conorpp/u2f-zero/hardware/case/u2f-zero-case v16.iges

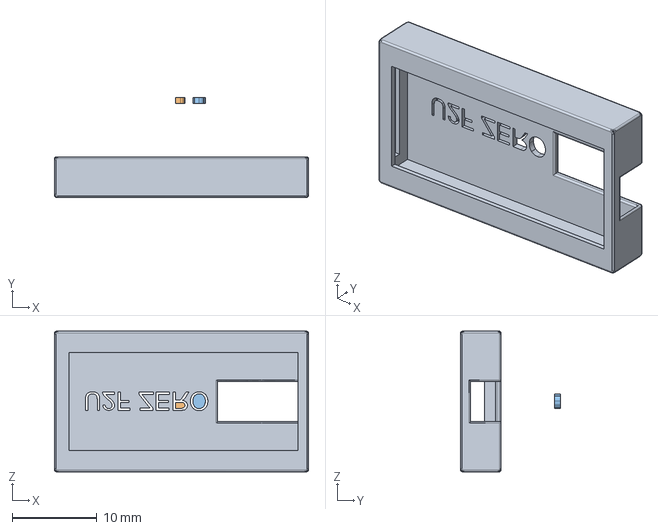
[picture p1: CAD file, 2016-05-28]
hardware/case/u2f-zero-case v16.iges
30.0 x 11.8 x 16.6 mm
