conorpp/u2f-zero/mechanical/flashing_harness.FCStd

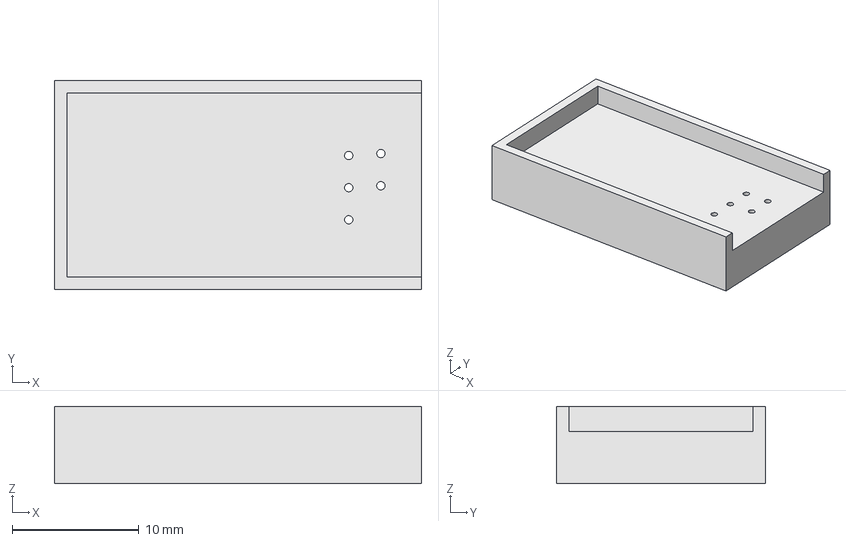
[picture p2: CAD file, 2016-06-05]
mechanical/flashing_harness.FCStd
29.0 x 16.5 x 6.10 mm
