conorpp/u2f-zero/hardware/case/u2f-zero-case .stl

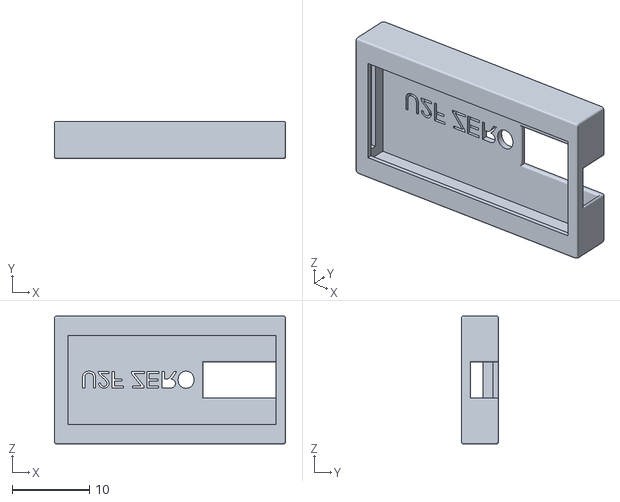
[picture p3: CAD file, 2016-05-28]
hardware/case/u2f-zero-case .stl
30.0 x 4.80 x 16.6
