conorpp/u2f-zero/(list of files, cad)

Other CAD files:
mechanical/flashing_harness.stl
