conorpp/u2f-zero/(threads)

Thread 17 (2016-06-23):

Consider crowdfunding

mkroman, 2016-06-23:
Hi - I love the project, thanks for making it! Already looking forward to building one soon.

Have you considered starting a crowdfunding campaign to get a low-cost u2f solution into the hands of the people?

I was thinking something like submitting it to http://www.seeedstudio.com/propagate/app/start/ and getting a quotation, then maybe create a project on https://www.crowdsupply.com/ to gather the funds and manufacture in larger bulk at a much lower cost.

With that said, I have no experience with manufacturing or crowdfunding - I just think it's something people would be interested in.

conorpp, 2016-06-23:
I'm currently in the process of ordering a small batch to be assembled after which I'll probably put on Amazon.

Crowd funding seems cool; I'm just not all convinced it would be necessary for this project.  If the order I'm currently in the process of eventually sells out then it will be worth it to look more into this.

I can create a timeline for this in the wiki if other people want to be involved.

jpouellet, 2016-06-24:
[int3.cc](http://int3.cc/) ([about](http://int3.cc/pages/about-us)) is relevant too, but I think you're on the right track already.

Closed 2016-08-15.

Thread 21 (2016-07-05):

1.6 mm PCBs are too thin

conorpp, 2016-07-05:
2-2.4 mm PCBs will make a proper connection.  1.6 mm like from Osh park will be wobbly and require some electrical tape or something similar to be added.

Currently updating wiki to reflect this and recommend a different PCB fab.

conorpp, 2016-07-08:
updated wiki with other options

Closed 2016-07-08.

Thread 23 (2016-07-12):

Add a way to make it updateable via USB

jumoog, 2016-07-12:
add FTDI FT2232 to make the u2f-zero updateable via USB (using the C2/JTAG interface of the EFM8UB1 series)

conorpp, 2016-07-12:
I'm not sure what you mean "using the C2/JTAG interface of the EFM8UB1 series".  It's can always be updated via the C2 interface.

To update over USB, there needs to be a bootloader.  There is probably a 1-2 KB of program memory leftover that the bootloader could be written in.  However, I don't think it would be any more convenient of a DIY project as the initial bootloader must be programmed via the C2 interface anyways.

jumoog, 2016-07-12:
i dont want spend money on a extra programmer

conorpp, 2016-07-13:
Assuming that everyone has an Arduino lying around, you could get this project to work:

https://github.com/x893/C2.Flash

Happy hacking!

jpouellet, 2016-07-15:
From a security perspective I do not like the idea of it being re-programmable over USB. The more complex of an interface you expose from the device to the machine you plug it into, the larger your effective attack surface.

The code required for the USB stack is non-trivial, and I would even be in favor of punting that to a separate USB->serial FTDI chip (or Cortex-M0 or something, because of FTDI's "anti-piracy" shenanigans), but the trade off there is increased cost per device.

Closed 2016-07-12.

Thread 24 (2016-07-25):

settings for making project in Simplicity Studio

bensteinberg, 2016-07-25:
I'm having trouble building the project in Simplicity Studio. I got past some errors by installing the Keil license, but I'm still seeing some problems: one is `*** ERROR C249 IN LINE 368 OF /Users/ben/Documents/code/u2f-zero/firmware/src/u2f_atecc.c: 'DATA': SEGMENT TOO LARGE` -- when I change the memory model (in project properties, C/C++ build settings) from small or compact to large, I get `*** ERROR C202 IN LINE 57 OF /Users/ben/Documents/code/u2f-zero/firmware/lib/efm8ub1/bsp/efm8_memory_lcd/src/spi.c: 'BSP_DISP_CS': undefined identifier`. Can you tell me what your settings are for building this project?

conorpp, 2016-07-26:
You should not need to change the memory model.

I'm a little confused for your second error because `u2f-zero/firmware/lib/efm8ub1/bsp` does not exist in the repo and should not be there.  Compiling more code then necessary would cause an issue.

Double check that the optimization level is 9 and that optimization favors size (properties -> settings -> C/C++ build -> optimization).  Also the device should be shown as EFM8UB10F16G in project explorer.

tbh I would start over and reimport the project now that you have the Keil license worked out.

bensteinberg, 2016-07-26:
Thanks! I deleted, re-cloned, and imported the project -- now I'm getting the following five errors:

    *** ERROR L127: UNRESOLVED EXTERNAL SYMBOL
    SYMBOL:  __attest
    MODULE:  ./src/u2f_atecc.OBJ (U2F_ATECC)

    *** ERROR L127: UNRESOLVED EXTERNAL SYMBOL
    SYMBOL:  __attest_size
    MODULE:  ./src/u2f_atecc.OBJ (U2F_ATECC)

    *** ERROR L128: REFERENCE MADE TO UNRESOLVED EXTERNAL
    SYMBOL:  __attest
    MODULE:  ./src/u2f_atecc.OBJ (U2F_ATECC)
    ADDRESS: 1003C86H

    *** ERROR L128: REFERENCE MADE TO UNRESOLVED EXTERNAL
    SYMBOL:  __attest
    MODULE:  ./src/u2f_atecc.OBJ (U2F_ATECC)
    ADDRESS: 1003C88H

    *** ERROR L128: REFERENCE MADE TO UNRESOLVED EXTERNAL
    SYMBOL:  __attest_size
    MODULE:  ./src/u2f_atecc.OBJ (U2F_ATECC)
    ADDRESS: 1003C50H

I have the device and the debug adapter connected, but I presume it's not necessary for the build step.

conorpp, 2016-07-26:
You need to program the setup build file first and then run configuration
script to generate the attestation certificate (__attest symbol).

See the steps in the wiki. Building a U2F token -> Programming.

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

bensteinberg, 2016-07-26:
Ah, of course. I did that, but didn't copy the certificate over from the first attempt. I'll try it this evening when I get back to that computer.

bensteinberg, 2016-07-27:
OK, I got it to compile -- I think I may have messed up the attestation certificate, though. I'll close this ticket, solder up another one, and start from scratch. Thanks for your help!

conorpp, 2016-07-27:
You can just reprogram the setup.hex file rerun the configuration to make
another attestation certificate and it will still work.

bensteinberg, 2016-07-29:
Thanks, working fine now -- it might even have been working fine earlier, except that the device never pulsed a green light, only red. I've checked the device at https://demo.yubico.com/u2f, though, so I know it works. I may have soldered the LED in backwards.... BTW, the photo at the top of https://github.com/conorpp/u2f-zero/wiki/Building-a-U2F-Token is of an old revision of the board, looks like. I'd offer up a picture of mine as a current example if I were more convinced of its correctness.

conorpp, 2016-07-29:
Nice.  Yes the pcb photo is on an out of date pcb but all the part
orientations are the same.  If the red dot on the LED is oriented on the
left side then it is correct.  Another soldering issue could be that the
red and green pins got bridged.

If you can get a good image of your board (which is the latest pcb) that
would be great to replace the old image on the wiki.

On Jul 29, 2016 8:57 AM, "Ben Steinberg" <notifications@github.com> wrote:

Thanks, working fine now -- it might even have been working fine earlier,
except that the device never pulsed a green light, only red. I've checked
the device at https://demo.yubico.com/u2f, though, so I know it works. I
may have soldered the LED in backwards.... BTW, the photo at the top of
https://github.com/conorpp/u2f-zero/wiki/Building-a-U2F-Token is of an old
revision of the board, looks like. I'd offer up a picture of mine as a
current example if I were more convinced of its correctness.

—
You are receiving this because you commented.

Reply to this email directly, view it on GitHub
<https://github.com/conorpp/u2f-zero/issues/24#issuecomment-236173315>, or mute
the thread
<https://github.com/notifications/unsubscribe-auth/ADwm9S7-pNs1qB8F4212_JnqdScfesu8ks5qafjEgaJpZM4JUEaU>
.

bensteinberg, 2016-08-03:
Thanks. I had the LED rotated 90 degrees. Rework on a hot surface did the trick. I've been trying to get a good photo, but haven't managed one yet with decent lighting, nice soldering, clean component placement, and visible component markings. I'll try some more, and have more PCBs coming from Dirty PCBS if I can't get a good shot of one of my first three devices.

Closed 2016-07-27.

Thread 25 (2016-09-08):

[Hardware] Key Ring Durability

erichahn, 2016-09-08:
I've been having some issues with how much the keyring hole has been worn away.
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
*I think we have the same key ring

I also lost C4 a while back. I blame heating the pad too long, my fault on that one.

martenwikman, 2016-09-10:
I think it would be a good idea if the board was extended a little so the hole would have more clearance to the board edge. Hole should be plated and some VIAs inserted in the pad itself like the picture below ( picture stolen from https://blogs.mentor.com/tom-hausherr/blog/tag/pcb-mounting-holes/)
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

jaredfolkins, 2016-09-25:
Instead of modifying any design I used an aftermarket keychain solution for low friction. The wire is wrapped in plastic.

https://www.amazon.com/bayite-BYT-WKC-4INP12-Inches-Stainless-Keychains/dp/B01CLGTBFA

Works fine and the wear is not severe nor do I anticipate the device to fail or become lost because of the wear in the keyring hole.

YMMV

alleybeachelectric, 2016-12-21:
Is there a 3d printable case that could be used to protect the PCB? If not, I don't mind creating one ;)

conorpp, 2016-12-25:
Yes, although it might not be very good.  Improvements/replacements welcome :)
https://github.com/conorpp/u2f-zero/tree/master/hardware/case

rspeed, 2017-01-16:
I wonder if something like Plasti Dip would be a good solution for this.

conorpp, 2017-01-25:
Updated PCB to use a plated hole / via as suggested by @martenwikman

Closed 2017-01-25.

Thread 28 (2016-09-29):

[Question] Porting u2f-zero to Digispark

Akasurde, 2016-09-29:
This is rather a question than a issue.
Can we port this port this code to [DigiSpark](http://digistump.com/category/1) ? It would be nice.

ccoenen, 2016-09-29:
This circuit uses a [cryptographic coprocessor](http://www.atmel.com/Images/Atmel-8923S-CryptoAuth-ATECC508A-Datasheet-Summary.pdf) which is not on the digispark. At the very least this would have to be added. I'm not sure the ATtiny on the Digispark could even talk to it. It does not have I2C, so you'd have to [jump through some hoops](http://playground.arduino.cc/Code/USIi2c) to get this set up first.

I'm not directly involved in this project, so a more detailed answer would have to come from the actual author.

conorpp, 2016-09-29:
The code was written so it could be ported easily.

It does use an I2C peripheral to handle ECC and SHA256 operations.  So you would have to fill in the API calls like [u2f_ecdsa_sign](https://github.com/conorpp/u2f-zero/blob/master/firmware/inc/u2f.h#L162), [u2f_new_keypair](https://github.com/conorpp/u2f-zero/blob/master/firmware/inc/u2f.h#L170), [u2f_sha256_start](https://github.com/conorpp/u2f-zero/blob/master/firmware/inc/u2f.h#L170), etc. with your own implementation.

The final U2F Zero firmware is about 15 KB which is already more than the 8 KB of the ATtiny.  Adding software implementations of ECC operations and SHA256 would be impossible.  Even if you could, it would be very slow -- on the scale of 1-10 seconds per ECC operation.

Akasurde, 2016-10-03:
@ccoenen @conorpp Thanks for info.

Closed 2016-09-29.

Thread 29 (2016-09-30):

Add method for unregistering individual services

zachreizner, 2016-09-30:
If I run out of space, I have to reregister every server just to make room. Not a problem right now, but I have 2 or 3 registrations I made just to test out the device.
Also consider making the 15 slot limit more prominent. That fact, along with the wipe-only removal option, came as an unhappy surprise to me while digging through the wiki.
Cool project though. I might buy another one just for testing.

conorpp, 2016-09-30:
Good point to bring up.

U2F prohibits having any identifiers for privacy reasons so that makes it tricky to delete individual services.  One idea I had was to have an option to delete the last service you authenticated to.

I decided it was not worth to implement because:
1.  Adds more complexity and is only usable via use of extra software
2.  Most people don't use U2F or 2FA for more than 15 different services.  Although duplicate registrations may be an issue as you point out.
3.  The tokens were design to be cheap so you can affordably buy more.

If you or someone wants to make a pull request with a good, low complexity solution, I will accept.

I'll make the 15 slot limit more prominent.

yanfali, 2016-10-13:
I'm running into an issue with a key I was experimenting with and have started using. I can register with github.com and a github enterprise instance at work, but then the github.com registration becomes invalid. I've done troubleshooting with github and they said everything looks ok in our instance database and on their end. Does the 15 limit and the inability to delete services seem like a reason as to why this would happen?

conorpp, 2016-10-13:
Okay to make sure I get this right:

1.  You register with github.com and it works.
2.  You register with enterprise.github.com and it works for enterprise.github.com
3.  Now github.com will not authenticate.

I don't think it's an issue with a 15 keys as registering a 16th service would [just fail and not overwrite over services](https://github.com/conorpp/u2f-zero/blob/master/firmware/src/u2f_atecc.c#L323).

It may be an issue with appid and keyid.  The appid is a static hash of the domain being authenticated.  The keyid is the identifier for the key.  The server supplies both of these when authenticating, and the token uses the keyid to look up the key and it's copy of the appid received during registration.  It checks that the supplied appid and stored appid are the same.  Then it proceeds to authenticate.

Do you know if the keyid for both Github records is different?  What about the appid?

yanfali, 2016-10-13:
I do know what the enterprise version does, but I'm not sure what the github.com version does. I have a support ticket open and I'm going to try and get them to engage on this subject with us. I can also paste in my token info that I got from github enterprise because I've already deleted the key.

yanfali, 2016-10-13:
This is the trusted facets info from our enterprise instance:

```json
{"trustedFacets":[{"version":{"major":1,"minor":0},"ids":["https://github.private.corp.com"]}]}```

This is github.com:

```json
https://github.com/u2f/trusted_facets
{"trustedFacets":[{"version":{"major":1,"minor":0},"ids":["https://github.com","https://garage.github.com","https://machine-room.github.com","https://spider-skull-island.github.com","https://admin.github.com"]}]}```

This is the output from their database I've shared with their support:

```[#<U2fRegistration id: 4, user_id: 3, key_handle: "CBzkgQ", certificate: "MIIB0jCCATcCAQEwCgYIKoZIzj0EAwIwczELMAkGA1UEBhMCVVM...", public_key: "BGH8JfYExfhdB7aSGVtpuytEoaF/YpPjR2W4q/mybi93VjcT0pm...", counter: 11, nickname: "u2f zero personal", created_at: "2016-10-12 18:29:33", updated_at: "2016-10-12 18:29:56">]```

yanfali, 2016-10-14:
Github got back to me and to quote them:

```
Thanks for the update and posting an issue in the u2f-zero repository. It looks like you have been able to provide the information that conorpp has requested so far.

I can confirm that both the AppID and key handle are unique per GitHub instance, with GitHub.com and your GitHub Enterprise appliance using different values.

Please let us know if there is any further information we can provide that would be helpful for conorpp's ongoing investigation.
```

conorpp, 2016-10-14:
Awesome, thanks for the info and confirmation.  I will find some time over the next few days and try to reproduce.

conorpp, 2016-11-13:
This issue is succeeded by https://github.com/conorpp/u2f-zero/issues/36

Closed 2016-11-13.

Thread 30 (2016-10-31):

Difficulties with HID USB

saeugetier, 2016-10-31:
I build two U2F by myself. PCBs were ordered from DirtyPCB in beginning of October. I think that the very latest gerbers are used, because I ordered the PCBs via link in the wiki.

I soldered all parts on the PCB. The soldering joints are checked with a microscope. I found no short circuits.

After flashing SETUP.hex to board the USB connection is very unstable.

Sometimes the device is found, but most of the times the kernel is not able to initialize the USB device. dmesg | tail has following messages:

[72252.317662] usb 3-2: new low-speed USB device number 87 using xhci_hcd
[72252.318180] usb 3-2: Device not responding to setup address.
[72252.522419] usb 3-2: Device not responding to setup address.
[72252.726103] usb 3-2: device not accepting address 87, error -71
[72252.726177] usb usb3-port2: unable to enumerate USB device

I tried to compile the setup-firmware by myself. I got the same problem for both boards.

The debugger identifies the microcontroller as "EFM8UB11F16G"

conorpp, 2016-10-31:
Seems odd, some ideas:

- Maybe the USB pins are not soldered well
- Maybe the USB exposed pads are not making strong contact with the USB socket in your computer.  Try another port or holding it in firmly.

If no success, can you post a picture?

saeugetier, 2016-10-31:
I have tested the sticks on two different computers. For tests I plugged the stick in every single slot.

I have tested the resistance of the signal D+ and D-. The resistance between connector pad and "wire" on the micro controller housing is zero ohm.

Do I have to program any fuses? For example for the clock sources?

conorpp, 2016-10-31:
I just read you only flashed SETUP.hex -- did you finish the rest of the programming steps?

saeugetier, 2016-10-31:
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

saeugetier, 2016-10-31:
The SETUP.hex has to be flashed first. After flashing the stick should enumerate as HID adapter.

conorpp, 2016-10-31:
Hm, does the LED glow green when powered?

saeugetier, 2016-10-31:
The LED glows green. While pressing the button it is blue.

conorpp, 2016-11-13:
I have some DirtyPCBs on the way for the different project, so after I assemble them I can check if I can replicate the issue.  Will get back.

bmkillian, 2016-11-13:
Sounds good.  Just an FYI – this is a unit I purchased on Amazon, not one I
built myself. Thanks!

*From:* Conor Patrick [mailto:notifications@github.com]
*Sent:* Saturday, November 12, 2016 8:18 PM
*To:* conorpp/u2f-zero
*Subject:* Re: [conorpp/u2f-zero] Difficulties with HID USB (#30)

I have some DirtyPCBs on the way for the different project, so after I
assemble them I can check if I can replicate the issue. Will get back.

—
You are receiving this because you are subscribed to this thread.
Reply to this email directly, view it on GitHub
<https://github.com/conorpp/u2f-zero/issues/30#issuecomment-260162069>, or mute
the thread
<https://github.com/notifications/unsubscribe-auth/AL7kdQ74sq60wQxD2pGl83yjqIlmZP4Zks5q9nNIgaJpZM4KlE0S>
.

conorpp, 2016-11-13:
@bmkillian this is for a different issue

bmkillian, 2016-11-13:
I’m an idiot.  My apologies.

*From:* Conor Patrick [mailto:notifications@github.com]
*Sent:* Saturday, November 12, 2016 8:23 PM
*To:* conorpp/u2f-zero
*Cc:* Brandon; Mention
*Subject:* Re: [conorpp/u2f-zero] Difficulties with HID USB (#30)

@bmkillian <https://github.com/bmkillian> this is for a different issue

—
You are receiving this because you were mentioned.
Reply to this email directly, view it on GitHub
<https://github.com/conorpp/u2f-zero/issues/30#issuecomment-260162245>, or mute
the thread
<https://github.com/notifications/unsubscribe-auth/AL7kdd_-PN38ZSB5BVm5S21kSYE2O07Gks5q9nSMgaJpZM4KlE0S>
.

conorpp, 2018-01-04:
Sorry I never got around to this and I haven't heard about any similar issues.  There's been a layout update since this issue which likely helps with USB signal integrity

Closed 2018-01-04.

Thread 31 (2016-10-31):

Unable to build firmware with Simplicity Studio 4

raoulh, 2016-10-31:
Trying to build the firmware with simplicity studio 4.0 but it failed.
After doing file->import the u2fzero firmware into the workspace, the toolchain/board/part are not available. It seems the project does not have a correct config somehow.

How to build it?

conorpp, 2016-10-31:
Did you install the EFM8 device when installing simplicity studio?

saeugetier, 2016-10-31:
Have you tried Simplicity Studio 3 or 4? I had issues with version 4. Please try version 3.

raoulh, 2016-10-31:
Yes. I also can create a new project and build it correctly.

I found out that the project files:
https://github.com/conorpp/u2f-zero/blob/master/firmware/.project#L23
does contain this instead in my working project:
`<nature>com.silabs.ss.framework.ide.project.sls.core.SLSProjectNature</nature>`

No idea why... Do you build in the latest simplicity studio 4.0.1?

raoulh, 2016-10-31:
Version 4 here.

raoulh, 2016-10-31:
Ok, works with Simplicity Studio 3

ThomasWaldmann, 2016-11-06:
So, if it doesn't work with v4, add the version number to the u2f-zero docs?

conorpp, 2016-11-13:
I tried recreating the project in v4 but there's another problem with the program not compiling to a small enough size.  Program size grew by about 2KB from v3 to v4, which is quite significant for a 16KB memory microcontroller.   Silabs probably added a lot more code to the v4 SDK.

So only v3 will work.  I've update wiki.

ThomasWaldmann, 2016-11-13:
Thanks for updating the docs!

Closed 2016-11-13.

Thread 32 (2016-11-01):

Memory error w/ pamu2fcfg

yangwao, 2016-11-01:
Any idea what's happening?
Can I print more verbose output?
```
wao@astrid~> pamu2fcfg -d
USB send: 00ffffffff8600080807060504030201000000000000000000000000000000000000000000000000000000000000000000000000000000000000000000000000
USB write returned 65
now trying with timeout 2
now trying with timeout 4
USB read rc read 64
USB recv: ffffffff8600110807060504030201cafebac2020200000300000000000000000000000000000000000000000000000000000000000000000000000000000000
device USB_10c4_8acf_14200000 discovered as 'U2F Zero'
  version (Interface, Major, Minor, Build): 2, 2, 0, 0  capFlags: 3
JSON: { "challenge": "gY6upYqKqqSSZdIBimxsZntlK_3rslYBPjE3l2QBL60", "version": "U2F_V2", "appId": "pam:\/\/astrid.local" }
JSON challenge URL-B64: gY6upYqKqqSSZdIBimxsZntlK_3rslYBPjE3l2QBL60
client data: { "challenge": "gY6upYqKqqSSZdIBimxsZntlK_3rslYBPjE3l2QBL60", "origin": "pam:\/\/astrid.local", "typ": "navigator.id.finishEnrollment" }
JSON: { "challenge": "gY6upYqKqqSSZdIBimxsZntlK_3rslYBPjE3l2QBL60", "version": "U2F_V2", "appId": "pam:\/\/astrid.local" }
JSON app_id pam://astrid.local
USB send: 00cafebac28300470001030000004027872bd2fea557304d0e5666b286215ac58fd28f8ff11576e0f4222777aa8f3e88b509d12a3183116802af3e1f00039438
USB write returned 65
USB send: 00cafebac200a2f5249547ec997c43e48a6f9d200000000000000000000000000000000000000000000000000000000000000000000000000000000000000000
USB write returned 65
now trying with timeout 2
now trying with timeout 4
now trying with timeout 8
now trying with timeout 16
now trying with timeout 32
now trying with timeout 64
now trying with timeout 128
now trying with timeout 256
now trying with timeout 512
USB read rc read 64
USB recv: cafebac2830002921000000000000000000000000000000000000000000000000000000000000000000000000000000000000000000000000000000000000000
USB data (len 2): 9210
error: (-1) Memory error (e.g., out of memory)
```

conorpp, 2016-11-01:
Hi Matej,

I'm glad that the shipment made it.  I believe that is because the key is
registered to 15 services and is out of memory.  It only has enough WO
memory on secure chip for 15 private keys.  You can reset the registrations
by using the Python script client.  See "extras" in wiki.

Conor

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

yangwao, 2016-11-01:
Oh, yes! Thanks! :)
Well, I have struggle with that python utils, but I think it's b/c of my system (Darwin Kernel Version 16.0.0), but on linux it worked :)
```wao@astrid~/P/u/t/u2f_zero_client> ./client.py wipe
python hidapi module is required
try running:
     apt-get install libusb-1.0-0-dev libudev-dev
     pip install hidapi

yangwao, 2016-11-01:
I just as instructed, but this just failed for me 🎱  hints & tips?
```
wao@astrid~/P/u/t/u2f_zero_client> ./client.py wipe
opened  None
Press U2F button until the LED is no longer red.
Traceback (most recent call last):
  File "./client.py", line 279, in <module>
    do_wipe(h)
  File "./client.py", line 234, in do_wipe
    res = h.read(64, 10000)
  File "hid.pyx", line 122, in hid.device.read (hid.c:2686)
IOError: read error
```

conorpp, 2016-11-01:
Sometimes when you press the button it can momentarily disconnect power which breaks the wipe -- does it always do that?

yangwao, 2016-11-01:
Everytime, I just hold my thumb on button, it just blinks from bright red into bright blue then back to bright red and suddenly to bright blue and then dimmed blue. Sometimes there is missing second red blink and just went from first red into bright blue.
Oh and I just figured it out, I just need press it more times.
Maybe it should be there _Press **repeatedly** U2F button_
```
wao@astrid~/P/u/t/u2f_zero_client> ./client.py wipe
opened  None
Press U2F button until the LED is no longer red.
Wipe succeeded
```

Closed 2016-11-02.

Thread 36 (2016-11-09):

usage problem with multiple sites

crrodriguez, 2016-11-09:
Hi:

I hope someone can figure this out..

I registered the key on:

 - 3 google accounts.
- on a sentry.io account
- then github

This works fine...for a while After that I cannot register new services at all..and the key appears to get "full".. only a key wipe can restore functionality. I am aware there is a 15 key limit.. but I count only 5 registrations so far (it happended with just 4 too) can a website be buggy and fill the device with key rthat it ends not using  at all ?

How do I know how many slots are used up  for example ?

bmkillian, 2016-11-11:
I just received mine from Amazon and am having a similar issue as well:

Added 5 accounts to the device:

- 3 Google accounts

- 1 Github account

- 1 Dropbox account

As of now, two of the Google account keys have vaporized and no longer work after adding the GitHub and Dropbox account.  Any guidance for troubleshooting would be appreciated. Thanks!

crrodriguez, 2016-11-11:
@bmkillian the key that stopped working in my case was the github one.. maybe one of this sites is creating duplicates quickly and filling the device up.

bmkillian, 2016-11-12:
@crrodriguez - based on what you've said, I've started troubleshooting to see if the GitHub key is also my issue. It is.  I can fill the key with multiple Google and Dropbox accounts just fine, but the second I register GitHub, I lose the majority of my keys.  The glaring exception is the first Google key I registered on the key did remain.

conorpp, 2016-11-12:
@crrodriguez @bmkillian thanks for sharing the issue and troubleshooting.  I just started debugging and will report back soon.

bmkillian, 2016-11-12:
@conorpp - Excellent. Thank you.  Let me know if you need me to do anything else to help troubleshoot.

conorpp, 2016-11-13:
@crrodriguez

I've looked at Google and Github registrations closely.  Sometimes when U2F Zero registers successfully, Google or Github will not acknowledge the response and will be stuck in "Register your key" mode.  So if you register and the token goes Orange->light blue->green and Github or Google GUI has done nothing, then a key slot was wasted.  It won't be able to be used to authenticate later.  @crrodriguez, could this be why?

As to why u2f zero responses occasionally get ignored, I think it could be one of two reasons:
1.  USB HID/U2F client layer isn't properly reading messages.
2.  USB connection isn't reliable.

I haven't been able to replicate registrations vaporizing.  Even when the token fills up, it will not overwrite previous keys.  I tried registering with multiple Google accounts and then Github and was still able to authenticate to everything, even after filling up all key slots.

@bmkillian, by vaporized, do you mean an account won't be able to authenticate with a previously registered token, even after trying multiple times?  You aren't wiping them with the script in-between registrations, right?

bmkillian, 2016-11-13:
@conorpp - Here's the process that seems to yield the problem:

1. Register with Google acct. #1
2. Register with Google acct. #2
3. Register with Google acct. #3
4. Register with Dropbox

At this point, I can authenticate with all of the above accounts with no problem.  All of them work consistently

5. Register with Github

At this point, the following happens:
1. Google account #1 will authenticate
2. Google account #2 will _not_ authenticate.
3. Google account #3  will _not_ authenticate.
4. Dropbox account will _not_ authenticate.
5. Github account will authenticate.

Now, if I wipe the token with the client.py util, I'm able to re-register the token with any of the accounts _until_ I add GitHub back.  That's when things go awry and I can't authenticate into the accounts.  I can repeat the results of this consistently, so it doesn't appear that a weak USB connection is at stake.  Hope this makes sense. Thanks!

yanfali, 2016-11-13:
I had a similar issue incoming GitHub and GitHub enterprise. Registering the first wipes the 2nd.

conorpp, 2016-11-13:
Just noticed something -- if you try to authenticate a key to a service it wasn't registered to on Chrome, it will send register requests after getting denied, without any notice.  So it looks like it's authenticating but it's actually making useless registrations...  this is likely a bug in Chrome's U2F API or the same services are using the same library.

Here is a HID USB packet trace that other developers could use:
```
// Client requests CID
ffffffff8600086ea1814dff2d31d900000000000000000000000000000000000000000000000000000000000000000000000000000000000000000000000000

// Token assigns CID cafebabe
ffffffff8600116ea1814dff2d31d9cafebabe020200000300000000000000000000000000000000000000000000000000000000000000000000000000000000

// Client requests U2F version
cafebabe830007000300000000000000000000000000000000000000000000000000000000000000000000000000000000000000000000000000000000000000

// Token replies U2F_V2
cafebabe8300085532465f5632900000000000000000000000000000000000000000000000000000000000000000000000000000000000000000000000000000

// Client sends auth request
cafebabe83004e00020300000045c5a499a098adc962ac122727366e98fb5f6fd6cad8b69127733354ae03447058a54672b222c4cf95e151ed8d4d3c767a6cc3
cafebabe0049435943794e884f3d023a8229fd0404b1361b00000000000000000000000000000000000000000000000000000000000000000000000000000000

// Token replies U2F_SW_WRONG_PAYLOAD (denied, wrong key handle)
cafebabe8300026a8000000000000000000000000000000000000000000000000000000000000000000000000000000000000000000000000000000000000000

// Now client sends perfectly valid registration request, leading to bad registrations because user thinks it is an auth request
cafebabe830049000103000000404242424242424242424242424242424242424242424242424242424242424242414141414141414141414141414141414141
cafebabe004141414141414141414141414141000000000000000000000000000000000000000000000000000000000000000000000000000000000000000000
```

conorpp, 2016-11-13:
@bmkillian when it fails to authenticate, does it report an error, or just seem to do nothing?  Does the key still turn orange and then light blue -> green when pressing button?

bmkillian, 2016-11-13:
The website indicates the key isn’t registered.  Unfortunately, I don’t
recall the LED indications, but I’ll repeat the process and take note.

*From:* Conor Patrick [mailto:notifications@github.com]
*Sent:* Saturday, November 12, 2016 9:24 PM
*To:* conorpp/u2f-zero
*Cc:* Brandon; Mention
*Subject:* Re: [conorpp/u2f-zero] usage problem with multiple sites (#36)

@bmkillian <https://github.com/bmkillian> when it fails to authenticate,
does it report an error, or just seem to do nothing? Does the key still
turn orange and then light blue -> green when pressing button?

—
You are receiving this because you were mentioned.
Reply to this email directly, view it on GitHub
<https://github.com/conorpp/u2f-zero/issues/36#issuecomment-260164496>, or mute
the thread
<https://github.com/notifications/unsubscribe-auth/AL7kdfOGl4DH46whjXpXxGiiPq01yKYVks5q9oLGgaJpZM4KtEP_>
.

darconeous, 2016-11-30:
The phantom registration behavior from chrome is pretty weird.

But I'm puzzled as to why this would do anything bad. Don't you need to press the button in order for it to actually  perform a registration? Perhaps you should require that the button not be held down before a command is issued, requiring for the press to happen *after* the command is issued.

conorpp, 2016-12-01:
@darconeous Yes the button still needs to be pressed, it's just the user might press the button *anyways* in attempt to authenticate

conorpp, 2017-01-28:
Added just added support for on the fly key derivation so there is no longer a limit on key storage.  I think this should solve any issues with multiple sites and unsolicited register requests.

If anyone wants a new token please send me an email with your mailing address.

Closed 2017-01-28.

Thread 38 (2016-11-29):

Use key wrapping to eliminate 15-site limit

darconeous, 2016-11-29:
While 15-sites is a lot of sites, the limit is frustrating because there is no easy way to manage these keys without erasing all of them. It also isn't clear what happens when you reach this limit (I assume some sort of failure indication?).

Having such a limit is unnecessary if you use key wrapping to store the key inside of the key handle (or use a mechanism similar to [what Yubico uses](https://www.yubico.com/2014/11/yubicos-u2f-key-wrapping/) to securely derive the keys from the key handle) instead of storing the keys locally.

conorpp, 2016-11-29:
Key wrapping is a good idea but I decided against it at the start of the project.  The token was designed to be cheap and secure.  So it has a secure chip that only does P256 ECC and just enough memory to do U2F and USB HID.  So no AES/other secure crypto KDFs can be implemented as the resources are not there.  My though was, if a user needs more than 15 registrations, he can afford to get two keys because they are cheap.

Now I see it's caused [more frustration](https://github.com/conorpp/u2f-zero/issues/36) than I thought it would.  So a new revision that does key wrapping would require a new chip with ~8KB more memory and slightly better throughput.

I'm currently can't work on another revision.  I'd love to hand the project off to someone else that would be interested.

Also relevant: https://github.com/conorpp/u2f-zero/issues/9

darconeous, 2016-11-30:
For what it's worth, you don't need AES to implement a scheme like what Yubico is using: you just need SHA2, which is provided by your secure element.

conorpp, 2016-11-30:
And implement an HMAC to derive key?  Good point, there should be enough memory to add that.

conorpp, 2017-01-28:
Just added support for this.  A 256 bit master secret is stored write-only on the ATECC508 so the security level and isolation should be the same as before.  New key pairs are generated based on a sha256 hmac with the 256 bit master key, 32 bit random number, and appid.  The 32 bit random number is stored in the keyid along with sha256(private-key + some constants) which acts as a MAC to write a new private key to the ATECC508.

Private keys are written to the ATECC508 are masked with another random secret stored on the USB MCU.  This is done so an eaves dropper on the I2C bus cannot see the private key.

If anyone sees any potential issues, please share them here.

ad-m, 2017-02-02:
Well I think that even the master key is not sufficient to make do an identical token?

I make awaraness about [TREZOR feature](https://blog.trezor.io/why-you-should-never-use-google-authenticator-again-e166d09d4324):
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

conorpp, 2017-02-02:
@ad-m I'm not sure your point.  The master key is only located on the key which means you cannot make an identical token by design.  If you are programming on your own, you can choose to keep a copy of the master secret to allow copies to be made.

Allowing a user to change the master secret and make backups should be a separate issue.

ad-m, 2017-02-02:
@conorpp , thanks for you opinion. I'm not sure all terms, hence my wrong impression. But I try to get to know about it. I might go back to backup issue later in the future, but first I have to know well the source code and U2F implementations details.

Thanks for your works and project development.

darconeous, 2017-02-27:
One thing I was thinking about was using some of the unused key slots for multiple attestation certificate keys---the goal being to further obscure the relationship between registrations on multiple websites with the same token.

Whenever a new service is registered, it would use a different attestation certificate. The first attestation certificate used would be picked at random, and then it would go in a round-robbin.

For each new batch of keys, maybe the two oldest attestation certificates would be retired. This would make it much more ambiguous as to even which batch a key came from.

Ideally we would have a collection of counters as well and we would use a random one for each service. Unfortunately there are only two secure hardware counters...

Anyway, implementing both mechanisms would almost completely eliminate any ability to correlate the token across services.

darconeous, 2017-05-11:
I was having a look at 01e8528e30f2b97003444425990b33bcff600c8e.

Unless I'm reading this wrong, I don't seem to see where you are using a nonce in the calculation of the private key. Without a random nonce, using the same key on the same service for different accounts would yield the same key handle! This would make it trivial for a service to determine if two accounts are using the same token.

Could you describe the algorithm you are using for deriving the keys?

conorpp, 2017-05-11:
Key generation can be seen [here](https://github.com/conorpp/u2f-zero/blob/master/firmware/src/u2f_atecc.c#L238).  It is done using a 256-bit master secret for a sha256 digest that is generated offline during setup/programming of the token.  See [script](https://github.com/conorpp/u2f-zero/blob/master/tools/u2f_zero_client/client.py#L212) and [setup-firmware](https://github.com/conorpp/u2f-zero/blob/master/firmware/src/atecc508a.c#L557).  A [32 bit random number and the appid is also included](https://github.com/conorpp/u2f-zero/blob/master/firmware/src/u2f_atecc.c#L257) in the sha256 calculation.

darconeous, 2017-05-17:
Ah, I see. Looks reasonable.

But what's the purpose of `RMASK` and `WMASK`? And why is the [implementation of `u2f_appid_eq()` commented out](https://github.com/conorpp/u2f-zero/blob/master/firmware/src/u2f_atecc.c#L321-L341)?

darconeous, 2017-05-17:
Nevermind, I just saw this from above:

> Private keys are written to the ATECC508 are masked with another random secret stored on the USB MCU. This is done so an eavesdropper on the I2C bus cannot see the private key. The ATECC508 supports unmasking it.

Closed 2017-04-29.

Thread 39 (2016-11-30):

Allow side-loading attestation private key to ensure identity privacy

darconeous, 2016-11-30:
The attestation certificate and associated private key are only intended to be used to allow a service to determine if a given U2F token has been manufactured to known and trusted specifications. This certificate is specified by the U2F specification to be unique to "batches" of devices, not individual devices¹.

The attestation private key and certificate are not intended to be unique per device for a very important reason: Services can (and likely do) store at least some part of the attestation certificate at token registration. If unique, it would allow colluding services to identify when the same physical key is being used for different accounts on different services.

By making the attestation certificates unique to production batches instead of individual devices, hundreds or thousands of devices should have the same attestation certificate. This reduces the ability for services to collude to identify accounts which share a physical token.

----

¹ Tokens issued by private companies for internal use have different needs from individual consumers and often want unique attestation keys and certificates per-device for tracking purposes. For those applications, the current capability is great. However, consumer purchased tokens should have non-unique attestation certificates, and there is currently no way to accommodate this with the current codebase.

conorpp, 2017-01-28:
Thanks, this is now [supported](https://github.com/conorpp/u2f-zero/wiki/Building-a-U2F-Token#configuring).  If anyone wants a new token, please email me your mailing address.

Closed 2017-01-28.

Thread 40 (2016-12-01):

Doesn't register on Windows through FIDOboosterUno

scateu, 2016-12-01:
http://www.vancosys.com/fidobooster/
                                      
When I try to register it through "FIDOboosterUno for Windows 10 64bit"，U2F-Zero does give an indication for me to press the button. But FIDOboosterUno doesn't continue after I pressed it.
(The U2F-Zero device still keep the indication lights on)

While it works well for my Yubikey Neo.

Plus, what can I do if I want to debug this issue?

Thanks.

FIDOboosterUno Download links

Windows 10
 - http://www.vancosys.com/Resources/Setup_FIDOboosterUno(64)_Win10.exe
 - http://www.vancosys.com/Resources/Setup_FIDOboosterUno_Win10(32).exe

Windows 7/8
 - http://www.vancosys.com/Resources/Setup_FIDOboosterUno(64).exe
 - http://www.vancosys.com/Resources/Setup_FIDOboosterUno(32).exe

darconeous, 2016-12-01:
Have you confirmed that your token works for other sites, like Google? I wonder if the button on yours might be broke.

scateu, 2016-12-02:
It works for google, dropbox,fastmail, even for pam.d(linux/macOS), and firefox u2f plugin.

So it can be sure there is some compatibility issue with FIDObooster.

I have written to them, and get a response that they are working on it.

crrodriguez, 2016-12-05:
@scateu maybe you are hitting https://github.com/conorpp/u2f-zero/issues/36 ? can you check if the key is full already ?

scateu, 2016-12-06:
Actually, I tried after 'python client.py wipe' (and 5 press)...

0. `python client.py wipe`
1. Register a new key via FIDO Booster
2. U2F Zero: LED, Red
3. me pressing U2F Zero button, LED turns Blue
4. me releasing U2F Zero button, LED turns back to Red
5. FIDO Booster stills prompt "please press the button on your key"
6. ...... after pressing button for 15 times, LED indicates that key is full

conorpp, 2016-12-06:
@scateu to wipe you need to press button 5 consecutive times.  The client tool will let you know if it worked.

scateu, 2016-12-06:
"Actually, I tried after 'python client.py wipe' (and 5 press)..."

and it did wiped.

conorpp, 2016-12-06:
I just checked the debugging output and registration seems fine.  It's likely an issue with FIDO Booster not handling something right.  For instance, when all 15 slots are use up, the u2f zero replies with a valid error response indicating there is no memory.  Yet FIDO booster continues to send repeated registration requests.

The program probably has the typical try/except while loop.  It probably runs into an error parsing the u2f zero registration certificate which is different from Yubico's cert, causing it to resend another registration.  Yubico is probably what the FIDO Boost authors tested against.

scateu, 2016-12-06:
Thanks. I have reported this issue to Vancosys. Hope this information will
help them debug FIDO booster.

(CC: Bahram and Geoff from vancosys.com)

--
Wang Kang
Blog: http://scateu.me
Fingerprint: 011F 0492 97D6 5D75 8AC4  6458 D43F 3CE2 3353 B7BD
HAM Callsign: BH1RLW

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

conorpp, 2017-01-28:
Is this still being looked at or can I close?

scateu, 2017-02-04:
I am trying to program the latest firmware into U2F Zero. After that, I'll test it again.

conorpp, 2018-01-04:
Assuming I can close this, let me know if there are still issues.

GitHubMad, 2018-03-22:
On Windows 10, I also didn't succeed using U2F-zero with **FIDOboosterUno**.
I bought my U2F-zero [here](https://www.amazon.fr/U2F-Zero-U2-F/dp/B01L9DUPK6) around Xmas.
Tested in february.
So maybe issue should be re-open...

conorpp, 2018-03-22:
There was a faulty batch shipped around Christmas that was fixed by early January.  Email me your order ID and we can go from there

Closed 2018-01-04.

Thread 41 (2016-12-08):

DirtyPCBs links dead

kurtcarpenter, 2016-12-08:
Looks like the folks at DirtyPCBs redid their site, now neither of the links on the wiki Parts List work anymore. Can the wiki be updated with the new links? (found by searching the Shares page)

Panelized: http://dirtypcbs.com/store/designer/details/9836/997/u2f-zero-panel-gerbers-zip
Non-panelized: http://dirtypcbs.com/store/designer/details/9836/998/u2f-zero-gerbers-zip

conorpp, 2016-12-08:
Updated!  Thanks!

DurandA, 2017-09-28:
Out of curiosity, what PCB thickness did you get (using 2mm option) from *dirtypcbs*? I got some 1.85mm PCBs and these are very loose in the USB socket.

rickard-von-essen, 2017-09-29:
Some weeks ago I got a batch of 2 mm PCB's from DirtyPCB which where 2.06mm, the fits nicely. (And as a reference my Yubikey NEO is 2.33mm which is probably close to optimal.)

conorpp, 2017-09-29:
DirtyPCBs uses a number of different board houses which is probably the reason for the inconsistency.  Reopening issue to try to find a better PCB source to get something around 2.1-2.2 mm

Suggestions welcome

DurandA, 2017-10-02:
I'll try [FirstPCB](https://firstpcb.com/) and report back. Unfortunately only 2mm is available and I cannot find other suppliers with 2.1-2.3mm thickness without prohibitive prices.

What is the thickness of the unit sold on Amazon? Unfortunately I cannot order it in my country.

conorpp, 2017-10-02:
It's about 2.05 mm.  2.1-2.2 would probably be better.

DurandA, 2017-10-08:
I have very good experience with [printed.cz](http://www.printed.cz/eng/shop/set-full-mode). I just noticed they offer 2.2mm for an affordable price. However, they don't have low cost slow shipping options so it may be too expensive for hobbyists wanting to build a few units.

athavan-mahen, 2017-11-23:
Hi where can I get a downloadable version of these files
u2f-zero-panel-gerbers-zip,
u2f-zero-gerbers-zip
so I can try to use a different vendor for printing or to make some changed

Thank you

Thread 44 (2017-01-20):

Mouser vendor offers update

ad-m, 2017-01-20:
Hello,

Mouser updates they offers and most of parts are available from they too. I thinks is good to mention at least two vendors for each parts, so prepared patch. Unfortunately, I don't see any way to pull requests to GitHub wiki, so I paste below a patch.

Both vendors have high shipping costs to Poland in Europe (30$). I personally prefer Mouser than Digikey, due free shipping to Europe for orders up to 200 PLN (~ 48 $).  Digikey offers free shipping up to 200$ value. At the university in the student club we are planning to organize a workshop to perform tokens for members, so we performed the comparison offers of these suppliers. The cost of shipping is 1/5 of the order for us if no discount.

```patch
diff --git a/Parts-List.md b/Parts-List.md
index 8ed70ee..ad63577 100644
--- a/Parts-List.md
+++ b/Parts-List.md
@@ -6,19 +6,28 @@ You need these 8 surface mount parts per U2F token which can all be purchased fr

 * Microcontroller
     * Digikey: [EFM8UB11F16G-C-QSOP24](http://www.digikey.com/product-detail/en/silicon-labs/EFM8UB11F16G-C-QSOP24/336-3411-5-ND/5592439)
-    * Mouser: [EFM8UB11F16G-C-QSOP24](http://www.mouser.com/Search/ProductDetail.aspx?qs=h6RIvS%252bzmlfRbNYtg60NqQ%3d%3d)
-* Secure element [ATECC508A-SOIC8](http://www.digikey.com/product-detail/en/atmel/ATECC508A-SSHDA-B/ATECC508A-SSHDA-B-ND/5213053)
-* [RGB LED](http://www.digikey.com/product-detail/en/LTST-C19HE1WT/160-2162-1-ND/4866310) for status indication.
-* 100 Ohm current limiting [resistor](http://www.digikey.com/product-detail/en/CRCW0603100RFKEA/541-100HCT-ND/1179695).
-* [Zener diode](http://www.digikey.com/product-detail/en/DF5A5.6JE,LM/DF5A5.6JELMCT-ND/5403466) for ESD protection.
-* [Push button](http://www.digikey.com/product-detail/en/e-switch/TL3305AF260QG/EG5353CT-ND/5816198) for user input.
+    * Mouser: [EFM8UB11F16G-C-QSOP24](http://pl.mouser.com/search/ProductDetail.aspx?R=0virtualkey0virtualkeyEFM8UB11F16G-C-QSOP24)
+* Secure element:
+    * Digikey: [ATECC508A-SOIC8](http://www.digikey.com/product-detail/en/atmel/ATECC508A-SSHDA-B/ATECC508A-SSHDA-B-ND/5213053)
+    * Mouser: [556-ATECC508A-SSHDAB](http://eu.mouser.com/search/ProductDetail.aspx?R=0virtualkey0virtualkeyATECC508A-SSHDA-B)
+* [RGB LED] for status indication:
+    * Digikey: [Lite-On Inc. LTST-C19HE1WT](http://www.digikey.com/product-detail/en/LTST-C19HE1WT/160-2162-1-ND/4866310)
+    * Mouser: [Lite-On Inc. LTST-C19HE1WT](http://pl.mouser.com/ProductDetail/Lite-On/LTST-C19HE1WT/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)
+* 100 Ohm current limiting resistor:
+    * Digikey: [Vishay Dale CRCW0603100RFKEA](http://www.digikey.com/product-detail/en/CRCW0603100RFKEA/541-100HCT-ND/1179695)
+    * Mouser: [Vishay CRCW0603100RFKEA](http://pl.mouser.com/ProductDetail/Vishay/CRCW0603100RFKEA/)
+* Zener diode for ESD protection:
+    * Digikey: [Toshiba DF5A5.6JE,LM](http://www.digikey.com/product-detail/en/DF5A5.6JE,LM/DF5A5.6JELMCT-ND/5403466)
+*  Push button for user input:
+    * Digikey: [E-Switch TL3305AF260QG](http://www.digikey.com/product-detail/en/e-switch/TL3305AF260QG/EG5353CT-ND/5816198)
+    * Mouser: [E-Switch TL3305AF260QG](http://pl.mouser.com/ProductDetail/E-Switch/TL3305AF260QG/)
 * [4.7 uF bypass capacitor](http://www.digikey.com/product-detail/en/CL10B475KQ8NQNC/1276-2087-1-ND/3890173) and [0.1 uF bypass capacitor](http://www.digikey.com/product-detail/en/CL05A104MP5NNNC/1276-1443-1-ND/3889529).

 ## Programmers

-You can use any [EFM8 Silicon Labs development board](http://www.digikey.com/product-search/en/programmers-development-systems/evaluation-boards-embedded-mcu-dsp/2621773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) ($30-40).
+You can use any EFM8 Silicon Labs development board. It is available in [Digikey](http://www.digikey.com/product-search/en/programmers-development-systems/evaluation-boards-embedded-mcu-dsp/2621773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) and [Mouser](http://pl.mouser.com/ProductDetail/Silicon-Laboratories/SLSTK2000A/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) ($30-40).

-Or you can buy the [8 bit Silicon Labs debugger](http://www.digikey.com/product-detail/en/silicon-labs/DEBUGADPTR1-USB/336-1182-ND/807653) ($35).
+Or you can buy the 8 bit Silicon Labs debugger. It is available in [Digikey](http://www.digikey.com/product-detail/en/silicon-labs/DEBUGADPTR1-USB/336-1182-ND/807653) and [Mouser](http://pl.mouser.com/ProductDetail/Silicon-Laboratories/DEBUGADPTR1-USB/) ($35).

 ## Tools

```

conorpp, 2017-01-20:
I've updated the wiki, thanks!

Closed 2017-01-20.

Thread 45 (2017-01-22):

Is the programmer are really required?

ad-m, 2017-01-22:
Hello,

[Silicon Labs EFM8UB11F16G-C-QSOP24 datasheet](http://www.mouser.com/ds/2/368/EFM8UB1_DataSheet-793165.pdf) mention:
> All devices come pre-programmed with a USB bootloader. This bootloader resides in the code security page and last pages of code flash; it can be erased if it is not needed.

Is there a way to program a microcontroller through USB without development board or debugger mentioned in [Parts List](https://github.com/conorpp/u2f-zero/wiki/Parts-List)?

Greetings,

ad-m, 2017-01-22:
[AN945: EFM8 Factory Bootloader User Guide](https://www.silabs.com/Support%20Documents/TechnicalDocs/AN945.pdf) mention:
> All devices come pre-programmed with a UART (~500 bytes), SMBus (~500 bytes), or **USB HID (~1.5 kB) bootloader**. This bootloader resides in the code security page. If it's too large to fit in the code security page, it will also occupy the last pages of code flash. It can be erased if it is not needed.

conorpp, 2017-01-22:
Hi,

The Silabs provided bootloader seems to start in the security page (64 bytes) then jump to regular program memory.  Just about all of the program memory is used by the application so there's not really room for both.  Maybe with some careful tinkering, it could be possible to fit both (USB HID code reuse between bootloader and application, etc).  Another option could be to use the bootloader to load the application to configure the crypto chip and then overwrite everything when the final application is loaded.  In this case, you can only program the final application once without the need of extra hardware.

So yes with some more work at least _something_ in this direction could be worked out.

conorpp, 2017-01-28:
Just added support to use USB HID bootloader.  [Extra functionality](https://github.com/conorpp/u2f-zero/wiki/Extras-and-Usage) has to be remove for it all to fit.  See [wiki](https://github.com/conorpp/u2f-zero/wiki/Building-a-U2F-Token) for instructions.

Closed 2017-01-28.

Thread 46 (2017-01-24):

Register u2f-0 without phone?

richrumble, 2017-01-24:
Are there any services that allow you just use the u2f, without first using a phone? That is the use-case I bought this for, but as far as I can tell, Google/Github require you use a phone to enable 2fa, then you can use your u2f. Is there a way to test to see if it's working? I tried the fidobooster from vasco, it didn't see either of my devices when I pressed the buttons. I don't need/use dropbox etc, I wanted this for Google and Git exclusively. Windows seems to have the driver, chrome is ver 55...
-rich

richrumble, 2017-01-24:
Will u2f-0 work on the Yubico test site?
https://demo.yubico.com/start/u2f/neo
Mine don't seem to if they should work.

AdrianKoshka, 2017-01-24:
The only thing I could think of right off would be the `PAM` stuff for linux (I use it on my main desktop for 2FA login w/ lightdm, though I don't use a U2F-0 key specifically), otherwise I can't think of services that don't require a phone to enable 2FA then setup U2F.

richrumble, 2017-01-24:
Thanks! I was able to use a different PC and the Yubico/demo app as a test, they both appear to be working from that perspective. There is something on that other PC that is blocking the u2f-0. AFAIK a phone will have to be used first in order to use u2f-0 on these two services.
This was the link that actually worked: https://demo.yubico.com/u2f

Closed 2017-01-24.

Thread 50 (2017-02-10):

IndexError: list index out of range

dl8bb, 2017-02-10:
Hi folks,
  looks like I run into a similar issue than described in #48 .

```
./setup_device.sh gencert/ca/key.pem gencert/ca/cert.der
+ SETUP_HEX=../firmware/SETUP.hex
+ FINAL_HEX=../firmware/release/u2f-firmware.hex
+ FLASH_TOOLS=0
+ SN=
+ SN_build=
+ SN_setup=
+ [[ 2 != \2 ]]
+ attest_priv=gencert/ca/key.pem
+ attest_pub=gencert/ca/cert.der
+ [[ 2 != \2 ]]
+ export PATH=/home/bergt/bin:/usr/local/bin:/usr/bin:/bin:/usr/local/games:/usr/games:gencert:u2f_zero_client:flashing
+ PATH=/home/bergt/bin:/usr/local/bin:/usr/bin:/bin:/usr/local/games:/usr/games:gencert:u2f_zero_client:flashing
+ [[ 0 = 1 ]]
+ echo configuring...
configuring...
+ [[ -n '' ]]
+ client.py configure gencert/ca/key.pem pubkey.hex
opened  None
Device is configured.
read 15 bytes
[128, 15, 1, 35, 146, 137, 0, 0, 80, 0, 6, 60, 106, 15, 238, 192, 101, 0, 0, 0, 0, 0, 0, 0, 0, 0, 0, 0, 0, 0, 0, 0, 0, 0, 0, 0, 0, 0, 0, 0, 0, 0, 0, 0, 0, 0, 0, 0, 0, 0, 0, 0, 0, 0, 0, 0, 0, 0, 0, 0, 0, 0, 0, 0]
conf:  0123928900005000063c6a0feec06500c0005500837181018371c101837183718371c171010183718371c1718371837183718371ffffffff00000000ffffffff00000000ffffffffffffffffffffffffffffffff00005555ffff00000000000013003c0013003c0013003c0013003c003c003c0013003c0013003c0013003300
crc is  ['0xad', '0x9']
data is  []
Traceback (most recent call last):
  File "u2f_zero_client/client.py", line 345, in <module>
    do_configure(h, sys.argv[2],sys.argv[3])
  File "u2f_zero_client/client.py", line 199, in do_configure
    if data[1] == 1:
IndexError: list index out of range
+ [[ 1 -ne 0 ]]
+ sleep .2
+ [[ -n '' ]]
+ client.py configure gencert/ca/key.pem pubkey.hex
```

For me it looks like the read_n_tries() is returning no data.

BTW: I added -x flag to the shell bang to get more info about what's going on and also a print statment in u2f_zero_client/client.py so the line numbers are increased from original.

...
    196     data = read_n_tries(h,5,64,1000)
    197     print( 'data is ', [hex(x) for x in data])
    198
    199     if data[1] == 1:
    200         print( 'locked eeprom with crc ',crc)
...

Do you have any hints on how to fix this?

Kind regards,
birko
--

conorpp, 2017-02-10:
Hey Birko,

If can add an option for better verbosity and make a pull request, that would be great.

Are you using an old U2F Zero?

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

dl8bb, 2017-02-10:
Hi,
  what do you mean by a old U2F zero? I ordered the PCB from dirtypcbs.com at the beginning of Jan. 2017 and got them this week. I already build some u2f-zero sticks and try to work through the init procedure.

BTW: I used the SETUP.hex from the github to flash it. Just to try if I can flash. Was this the mistake? ...and I bricked my ATECC508A? :-(

regards,
birko
--

conorpp, 2017-02-10:
If you used firmware with commit [fe9cc54](https://github.com/conorpp/u2f-zero/tree/fe9cc54a9784d5024db310a06b84b7a5a5e8a8e0) or before (January 25) then it would have written the old ATECC508A configuration and will not work with the newer firmware.  You can replace the ATECC508A to use latest firmware or you can revert back to commit fe9cc54.

I just added two releases to make this easier for people that need to distinguish.

Closed 2017-04-29.

Thread 53 (2017-03-24):

SMD Parts are too damn small!

makefu, 2017-03-24:
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

I really like the project but i had much difficulty with soldering the parts onto the PCB. For one the parts you chose were just too damn small for soldering by hand. On the other hand the PCB itself is "huge" compared to the the parts placed. I'd love to see a version with somewhat bigger parts ( 0805 ), especially the five pins of the zener diode, the LED and the 0402 capacitor produced a lot of headache.

Besides that, keep up your work to make the community more secure!

jbheren, 2017-03-24:
I agree with that, especially the 0.1 capacitor & Diode, even if it can mak us proud when it works :)
Soldering by hand may work fine with 1206. I made a test on pcb with a milling machine and some wires are too thin for it.

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

conorpp, 2017-03-24:
@makefu Yeah I agree.  I can look into adding larger components later but it would be best if someone else could do this.  I think the zener, 0402 cap, and LED would all be easy to replace with slightly bigger versions.

@jbheren I recently accepted a [pull request](https://github.com/conorpp/u2f-zero/pull/37) that normalized the wire widths (among other things) and should improve milling/fab yield.  You might have better luck with the latest version.

jbheren, 2017-03-26:
Thanks @conorp, I made a milling simulation an it sounds much better with this version. last time I tested using the panel file which seems quite older.

conorpp, 2018-05-04:
Fixed by #80 thanks to @thenoviceoof

Closed 2018-05-04.

Thread 54 (2017-03-26):

USB HID Flashing / bootloader

jbheren, 2017-03-26:
Hi All,

I made an U2F Zero token from one [OSHPARK ](https://oshpark.com/shared_projects/Rq9evtm7) made PCB & spent some time trying to flash it :

- flashed the SETUP.boot after I converted the SETUP.hex from repository,
- Generated certificate and ran the Configuration. I had some errors but the flow said " device configured" so I tried the next step,
- Set the device to bootloader mode (took some time to understand we had to set it using `client.py bootloader`  after keeping finger on the switch (red LED),
- Flashed the built u2f-firmare after commenting out the needed defines (as defined in wiki) :

```
C:\Users\jb\Documents\AN945SW\Tools\Windows>efm8load.exe u2f-firmware.boot
Download over port: HID:10C4:EAC9

@@@@@@@@@@@@@@@@@@@@@@@@@@@@@@@@@@@@@@@@@@@@@@@@@@@@@@@@@@@@@@@@@@@@@@@@@@@@@@@@@@@@@@@@@@@@@@@@@@@@@@@@@@@@@@@@@@@@@AAAAAAC@@

Download complete with [ 7 ] errors
```

I Think the token moved a bit as I had left my hand on the switch...

Now It seems like I am unable to set the device back to bootloader mode. Do you think I bricked it ?

Thanks again for all the big work.

conorpp, 2017-03-26:
If you tried running

```bash
./u2f_zero_client/client.py bootloader
```

And it doesn't work, it may be bricked.  You can try programming the bootloader again with the efm8load.exe tool.  If it lost power during the flashing then it probably got corrupted and is why it won't go back into bootloader mode.

jbheren, 2017-03-26:
Ok thanks, then I will try to build another one. Do you think it could be recovered using a dedicated programmer ?

conorpp, 2017-03-26:
Yes you will have no issue with bricking it/recovering when using a programmer

Oliv4945, 2018-04-23:
Hi @jbheren, did succeed to program another chip ?
I have the exactly the same error, might be related to #57

Also, for your information, as written in #57, you can put the device in bootloader again by shorting C2D pin to ground when powering the key.

j8048188, 2018-07-10:
I've been having the same programming issues as @jbheren. I can reset the u2f by shorting C2D and Ground when i plug the key into my computer. I'm happy to provide any files requested to help debug this.

Closed 2017-03-27.

Thread 56 (2017-04-02):

can't concat bytes to str in client.py:188

ad-m, 2017-04-02:
Hello,

I am tried to initialize some devices by USB programming. On Cywgin & Windows with Simplicity Studio 3 and .

As mentioned in the docs I executed:
``
cd ca/
./genca.sh
cd ../..
./setup_device.sh gencert/ca/key.pem gencert/ca/cert.der   # or path to your preferred attestation key pair
``

Then the LED is pulsing a green light and command line provides infinity output of errors like:
```
opened  None
Device is configured.
read 15 bytes
[128, 15, 1, 35, 95, 16, 0, 0, 80, 0, 166, 147, 83, 58, 238, 192, 137, 0, 0, 0, 0, 0, 0, 0, 0, 0, 0, 0, 0, 0, 0, 0, 0, 0, 0, 0, 0, 0, 0, 0, 0, 0, 0, 0, 0, 0, 0, 0, 0, 0, 0, 0, 0, 0, 0, 0, 0, 0, 0, 0, 0, 0, 0, 0]
Traceback (most recent call last):
  File "./u2f_zero_client/client.py", line 344, in <module>
    do_configure(h, sys.argv[2],sys.argv[3])
  File "./u2f_zero_client/client.py", line 188, in do_configure
    config = array.array('B',data[2:2+l]).tostring() + config[l:]
TypeError: can't concat bytes to str
opened  None
Device is configured.
read 15 bytes
[128, 15, 1, 35, 95, 16, 0, 0, 80, 0, 166, 147, 83, 58, 238, 192, 137, 0, 0, 0, 0, 0, 0, 0, 0, 0, 0, 0, 0, 0, 0, 0, 0, 0, 0, 0, 0, 0, 0, 0, 0, 0, 0, 0, 0, 0, 0, 0, 0, 0, 0, 0, 0, 0, 0, 0, 0, 0, 0, 0, 0, 0, 0, 0]
Traceback (most recent call last):
  File "./u2f_zero_client/client.py", line 344, in <module>
    do_configure(h, sys.argv[2],sys.argv[3])
  File "./u2f_zero_client/client.py", line 188, in do_configure
    config = array.array('B',data[2:2+l]).tostring() + config[l:]
TypeError: can't concat bytes to str
opened  None
Device is configured.
read 15 bytes
[128, 15, 1, 35, 95, 16, 0, 0, 80, 0, 166, 147, 83, 58, 238, 192, 137, 0, 0, 0, 0, 0, 0, 0, 0, 0, 0, 0, 0, 0, 0, 0, 0, 0, 0, 0, 0, 0, 0, 0, 0, 0, 0, 0, 0, 0, 0, 0, 0, 0, 0, 0, 0, 0, 0, 0, 0, 0, 0, 0, 0, 0, 0, 0]
Traceback (most recent call last):
  File "./u2f_zero_client/client.py", line 344, in <module>
    do_configure(h, sys.argv[2],sys.argv[3])
  File "./u2f_zero_client/client.py", line 188, in do_configure
    config = array.array('B',data[2:2+l]).tostring() + config[l:]
TypeError: can't concat bytes to str
opened  None
Device is configured.
read 15 bytes
[128, 15, 1, 35, 95, 16, 0, 0, 80, 0, 166, 147, 83, 58, 238, 192, 137, 0, 0, 0, 0, 0, 0, 0, 0, 0, 0, 0, 0, 0, 0, 0, 0, 0, 0, 0, 0, 0, 0, 0, 0, 0, 0, 0, 0, 0, 0, 0, 0, 0, 0, 0, 0, 0, 0, 0, 0, 0, 0, 0, 0, 0, 0, 0]
Traceback (most recent call last):
  File "./u2f_zero_client/client.py", line 344, in <module>
    do_configure(h, sys.argv[2],sys.argv[3])
  File "./u2f_zero_client/client.py", line 188, in do_configure
    config = array.array('B',data[2:2+l]).tostring() + config[l:]
TypeError: can't concat bytes to str
```
It references to [this line](https://github.com/conorpp/u2f-zero/blob/8931b3205b2b601a312053f92dd337a2877296d3/tools/u2f_zero_client/client.py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).

Now on Linux there is no errors like that if I try reproduce the issue without U2F device. It might be Python / Cygwin incompatibility.

```
In [1]: import array

In [2]: data = [128, 15, 1, 35, 95, 16, 0, 0, 80, 0, 166, 147, 83, 58, 238, 192, 137, 0, 0, 0, 0, 0, 0, 0, 0, 0, 0, 0, 0, 0, 0, 0, 0, 0, 0, 0, 0, 0, 0, 0, 0, 0, 0, 0, 0, 0, 0, 0, 0, 0, 0, 0, 0, 0, 0, 0, 0, 0, 0, 0, 0, 0, 0, 0]

In [3]:

In [3]: l = data[1]

In [4]: array.array('B',data[2:2+l]).tostring()
Out[4]: '\x01#_\x10\x00\x00P\x00\xa6\x93S:\xee\xc0\x89'

In [5]: type(array.array('B',data[2:2+l]).tostring())
Out[5]: str

In [6]: type(config[l:])
---------------------------------------------------------------------------
NameError                                 Traceback (most recent call last)
<ipython-input-6-dfbf22984aa3> in <module>()
----> 1 type(config[l:])

NameError: name 'config' is not defined

In [7]: config = "\x01\x23\x6d\x10\x00\x00\x50\x00\xd7\x2c\xa5\x71\xee\xc0\x85\x00\xc0\x00\x55\x00\x83\x71\x81\x01\x83\x71\xC1\x01\x83\x71\x83\x71\x83\x71\xC1\x71\x01\x01\x83\x71\x83\x71\xC1\x71\x83\x71\x83\x71\x83\x71\x83\x71\xff\xff\xff\xff\x00\x00\x00\x00\xff\xff\xff\xff\x00\x00\x00\x00\xff\xff\xff\xff\xff\xff\xff\xff\xff\xff\xff\xff\xff\xff\xff\xff\x00\x00\x55\x55\xff\xff\x00\x00\x00\x00\x00\x00\x13\x00\x3C\x00\x13\x00\x3C\x00\x13\x00\x3C\x00\x13\x00\x3C\x00\x3c\x00\x3C\x00\x13\x00\x3C\x00\x13\x00\x3C\x00\x13\x00\x33\x00"

In [8]: type(config[l:])
Out[8]: str

In [9]: array.array('B',data[2:2+l]).tostring() + config[l:]
Out[9]: '\x01#_\x10\x00\x00P\x00\xa6\x93S:\xee\xc0\x89\x00\xc0\x00U\x00\x83q\x81\x01\x83q\xc1\x01\x83q\x83q\x83q\xc1q\x01\x01\x83q\x83q\xc1q\x83q\x83q\x83q\x83q\xff\xff\xff\xff\x00\x00\x00\x00\xff\xff\xff\xff\x00\x00\x00\x00\xff\xff\xff\xff\xff\xff\xff\xff\xff\xff\xff\xff\xff\xff\xff\xff\x00\x00UU\xff\xff\x00\x00\x00\x00\x00\x00\x13\x00<\x00\x13\x00<\x00\x13\x00<\x00\x13\x00<\x00<\x00<\x00\x13\x00<\x00\x13\x00<\x00\x13\x003\x00'
``
I have to dig a bit in week 3-9 April 2017 over that.

conorpp, 2017-04-03:
Interesting.  Maybe changing the line to something like this could be a possible fix?

```python
config = array.array('B',data[2:2+l]).tostring() + array.array('B',config[l:]).tostring()
```

conorpp, 2018-01-04:
I'm assuming this was fixed, let me know if there are still issues.

Closed 2018-01-04.

Thread 57 (2017-04-13):

USB Problem after writting final compiled firmware.

racerxdl, 2017-04-13:
I followed the steps in the wiki and I'm getting this error when compiling:
```
*** WARNING L15: MULTIPLE CALL TO FUNCTION
    NAME:    _USB_WRITEFIFO/EFM8_USBDEP
    CALLER1: ?C_C51STARTUP
    CALLER2: USBIRQHANDLER/EFM8_USBDINT

*** WARNING L15: MULTIPLE CALL TO FUNCTION
    NAME:    _USBD_WRITE/EFM8_USBD
    CALLER1: ?C_C51STARTUP
    CALLER2: USBIRQHANDLER/EFM8_USBDINT
```

that leads to unrecognizable device:
```
[30067.125863] usb 1-5.2: new full-speed USB device number 112 using xhci_hcd
[30067.213843] usb 1-5.2: device descriptor read/64, error -71
[30067.401887] usb 1-5.2: device descriptor read/64, error -71
[30067.589863] usb 1-5.2: new full-speed USB device number 113 using xhci_hcd
[30067.673905] usb 1-5.2: device descriptor read/64, error -71
[30067.861880] usb 1-5.2: device descriptor read/64, error -71
[30068.053901] usb 1-5.2: new full-speed USB device number 114 using xhci_hcd
[30068.074414] usb 1-5.2: device descriptor read/8, error 0
[30068.194386] usb 1-5.2: device descriptor read/8, error 0
[30068.381877] usb 1-5.2: new full-speed USB device number 115 using xhci_hcd
[30068.398392] usb 1-5.2: device descriptor read/8, error 0
[30068.518371] usb 1-5.2: device descriptor read/8, error 0
[30068.622050] usb 1-5-port2: unable to enumerate USB device\
```

I disabled the 4 features in the header as mention (to not corrupt the bootloader) and if I compile with **ATECC_SETUP_DEVICE** defined (so setup mode) the generated hex file works fine (the USB device works, and u2f client list devices perfectly). If I disable **ATECC_SETUP_DEVICE** I get the compilation warning and the device doesn't work.

I'm using a programmer to reset everything when it goes bad, since I cannot reset it in the normal way.

racerxdl, 2017-04-13:
Just notice if I just leave the genca with default parameters (without adding anything) the key inside the firmware program is about 3 bytes less and it works. If I change any of the parameters on genca, it grows some bytes and stops working,

racerxdl, 2017-05-03:
Ok so its not size related, because now i rebuild the CA, gave it 18 more bytes (instead of 3) and its working. So it looks like some field cannot be filled on CA.

conorpp, 2017-05-03:
Thanks for sharing this.  The warning you get during compilation happen every time and shouldn't be an issue.  Are you still programming using the bootloader?

racerxdl, 2017-05-03:
Yeah, but when it doesn't work, it breaks the USB bootloader (since it get 3 bytes error writting the firmware), then I use the programmer to reset the device back to the bootloader. I will check some more parameters on `makeca` to see what causes the failure.

rickard-von-essen, 2017-09-23:
I think I get the same problem. Did you figure out what's causing this?

racerxdl, 2017-09-23:
Seens related to CA Cerfificate. I managed to change just the company name and got it working. Looks like its one of `makeca` parameters but I couldn't figured out which one.

conorpp, 2017-09-23:
There might just too much data with all the fields filled in the cert, causing the memory to overwrite the bootloader page.  Could you post what firmware (and cert) sizes worked and didn't work?

samop, 2018-02-10:
The problem still persists and I cannot program firmware into the controller. However, according to Application note AN945, bootloader can be invoked with by connecting C2D pin to ground. There is no need for programmer to fix the bootloader if something goes wrong during flashing.

Oliv4945, 2018-04-19:
Hi, I am running into the same issue. Did you find any solution ?
What are working values for `makeca` ? I am unable to generate valid parameters.

The U2F is correctly is recognized with setup.hex:
```
./client.py list
interface_number : -1
manufacturer_string : Silicon Labs
path : \\?\hid#vid_10c4&pid_8acf#6&2fbc42&0&0000#{4d1e55b2-f16f-11cf-88cb-001111000030}
product_id : 35535
product_string : U2F Zero
release_number : 256
serial_number : CAFEBABEFFFFFFFF
usage : 1
usage_page : 61904
vendor_id : 4292
```
I can do the setup:
```
 ./setup_device.sh gencert/ca/key.pem gencert/ca/cert.der             
configuring...
opened  None
Device is configured.
read 15 bytes
[128, 15, 1, 35, 32, 168, 0, 0, 80, 0, 219, 100, 183, 198, 238, 192, 73, 0, 0, 0, 0, 0, 0, 0, 0, 0, 0, 0, 0, 0, 0, 0, 0, 0, 0, 0, 0, 0, 0, 0, 0, 0, 0, 0, 0, 0, 0, 0, 0, 0, 0, 0, 0, 0, 0, 0, 0, 0, 0, 0, 0, 0, 0, 0]
conf:  012320a800005000db64b7c6eec04900c0005500837181018371c101837183718371c171010183718371c1718371837183718371ffffffff00000000ffffffff00000000ffffffffffffffffffffffffffffffff00005555ffff00000000000013003c0013003c0013003c0013003c003c003c0013003c0013003c0013003300
crc is  ['0xf1', '0xa5']
locked eeprom with crc  [241, 165]
wkey e68a01ce0d14d40c7d2e299780f764e8ecdde0188de7cbb09bb6a8da8e33a273a6a678eb
writing keys to  pubkey.hex
Done.  Putting device in bootloader mode.
generate attestation certificate...
for file gencert/ca/cert.der
done.
building...
Open Simplicity Studio and rebuild final program.
Then you can erase and reprogram U2F Token.
```
I have the same warning during the link:
```
LX51 LINKER/LOCATER V4.66.30.0 - SN: K1RIC-S0KLQZ
COPYRIGHT ARM Germany GmbH 1995 - 2014
@u2f-firmware.lnp "./src/InitDevice.OBJ",
"./src/Interrupts.OBJ",
"./src/SILABS_STARTUP.OBJ",
"./src/bsp.OBJ",
"./src/callback.OBJ",
"./src/descriptors.OBJ",
"./src/u2f.OBJ",
"./src/u2f_hid.OBJ",
"./lib/efm8ub1/peripheralDrivers/src/usb_0.OBJ",
"./lib/efm8_usb/src/efm8_usbd.OBJ",
"./lib/efm8_usb/src/efm8_usbdch9.OBJ",
"./lib/efm8_usb/src/efm8_usbdep.OBJ",
"./lib/efm8_usb/src/efm8_usbdint.OBJ",
"./lib/efm8_assert/assert.OBJ",
"./tests/tests.OBJ",
"./src/atecc508a.OBJ",
"./src/cert.OBJ",
"./src/custom.OBJ",
"./src/eeprom.OBJ",
"./src/i2c.OBJ",
"./src/main.OBJ",
"./src/u2f_atecc.OBJ"
TO "U2F-FIRMWARE.OMF.CRBUILD" REMOVEUNUSED PRINT(.\u2f-firmware.m51) PAGEWIDTH (120) PAGELENGTH (65) CLASSES( CODE(C:0x0 - C:0x3ffe), CONST(C:0x0 - C:0x3ffe), ECODE(C:0x0 - C:0x3ffe), HCONST(C:0x0 - C:0x3ffe), XDATA(X:0x0 - X:0x3ff), HDATA(X:0x0 - X:0x3ff))

*** WARNING L15: MULTIPLE CALL TO FUNCTION
    NAME:    _USB_WRITEFIFO/EFM8_USBDEP
    CALLER1: ?C_C51STARTUP
    CALLER2: USBIRQHANDLER/EFM8_USBDINT

*** WARNING L15: MULTIPLE CALL TO FUNCTION
    NAME:    _USBD_WRITE/EFM8_USBD
    CALLER1: ?C_C51STARTUP
    CALLER2: USBIRQHANDLER/EFM8_USBDINT

Program Size: data=104.7 xdata=1013 const=578 code=14946
LX51 RUN COMPLETE.  2 WARNING(S),  0 ERROR(S)
Finished building target: u2f-firmware.omf
```

Then flashing the software reports errors. I do not find any documentation on how to get the error.
```
./efm8load.exe u2f-firmware.boot
Download over port: HID:10C4:EAC9

@@@@@@@@@@@@@@@@@@@@@@@@@@@@@@@@@@@@@@@@@@@@@@@@@@@@@@@@@@@@@@@@@@@@@@@@@@@@@@@@@@@@@@@@@@@@@@@@@@@@@@@@@@@@@@@@@@@@@AAAAAAC@@

Download complete with [ 7 ] errors
```

Thank you
Oliv'

j8048188, 2018-07-10:
If you run efm8load.exe -t firmware.boot it'll give you the full download details, showing the errors.
My errors look liek the following:
`C:\Users\Jared\Downloads\u2f\release>efm8load.exe -t firmware.boot
Download over port: HID:10C4:EAC9

$ 04 31 A5 F1 00 -> @
$ 83 32 00 00 FF 24 3B 7E -> @
$ 83 33 00 80 F6 08 DF FA -> @
$ 83 33 01 00 A3 C8 C5 82 -> @
$ 83 33 01 80 22 BB FE 02 -> @
$ 83 32 02 00 E0 38 F0 22 -> @
$ 83 33 02 80 82 C8 F2 E5 -> @
$ 83 33 03 00 02 03 4F 50 -> @
$ 83 33 03 80 A3 C5 83 C5 -> @
$ 83 32 04 00 F8 02 08 5A -> @
$ 83 33 04 80 82 88 83 E4 -> @
$ 83 33 05 00 F0 02 DF F4 -> @
$ 83 33 05 80 F5 80 3C 89 -> @
$ 83 32 06 00 83 CC E4 93 -> @
$ 83 33 06 80 68 E7 09 F2 -> @
$ 83 33 07 00 80 87 80 87 -> @
$ 83 33 07 80 E9 98 EA 9C -> @
$ 83 32 08 00 82 AB 83 23 -> @
$ 83 33 08 80 01 E5 F0 A3 -> @
$ 83 33 09 00 02 12 15 0D -> @
$ 83 33 09 80 FD 02 0A 0D -> @
$ 83 32 0A 00 0C 7F 01 22 -> @
$ 83 33 0A 80 14 90 EC 4D -> @
$ 83 33 0B 00 70 12 14 C7 -> @
$ 83 33 0B 80 74 F0 90 01 -> @
$ 83 32 0C 00 12 21 E2 12 -> @
$ 83 33 0C 80 E4 FD 80 05 -> @
$ 83 33 0D 00 C4 13 54 03 -> @
$ 83 33 0D 80 3C 79 9E ED -> @
$ 83 32 0E 00 70 37 EF 24 -> @
$ 83 33 0E 80 45 13 F5 C2 -> @
$ 83 33 0F 00 0B FD 80 52 -> @
$ 83 33 0F 80 26 57 90 03 -> @
$ 83 32 10 00 53 C0 03 C0 -> @
$ 83 33 10 80 B8 12 2F 67 -> @
$ 83 33 11 00 8D 90 02 6E -> @
$ 83 33 11 80 7E 69 7F 84 -> @
$ 83 32 12 00 12 03 B8 90 -> @
$ 83 33 12 80 73 24 C1 60 -> @
$ 83 33 13 00 24 74 6D 75 -> @
$ 83 33 13 80 7C 00 FD 02 -> @
$ 83 32 14 00 01 74 54 7F -> @
$ 83 33 14 80 DC E0 75 F0 -> @
$ 83 33 15 00 F5 83 22 90 -> @
$ 83 33 15 80 4E 90 02 6B -> @
$ 83 32 16 00 35 7A 02 79 -> @
$ 83 33 16 80 80 00 90 02 -> @
$ 83 33 17 00 8F F0 12 01 -> @
$ 83 33 17 80 AD 03 90 02 -> @
$ 83 32 18 00 00 79 21 22 -> @
$ 83 33 18 80 03 02 19 46 -> @
$ 83 33 19 00 E0 60 05 EF -> @
$ 83 33 19 80 00 74 E0 12 -> @
$ 83 32 1A 00 12 06 3A 90 -> @
$ 83 33 1A 80 02 CA E0 44 -> @
$ 83 33 1B 00 90 02 D8 E5 -> @
$ 83 33 1B 80 D0 E0 14 60 -> @
$ 83 32 1C 00 30 24 02 70 -> @
$ 83 33 1C 80 90 02 CE E0 -> @
$ 83 33 1D 00 60 06 12 3A -> @
$ 83 33 1D 80 90 03 B7 E0 -> @
$ 83 32 1E 00 7F 01 90 02 -> @
$ 83 33 1E 80 7B 01 7A 02 -> @
$ 83 33 1F 00 C7 80 3A 12 -> @
$ 83 33 1F 80 07 E4 90 02 -> @
$ 83 32 20 00 EA F0 A3 EB -> @
$ 83 33 20 80 70 0A 90 02 -> @
$ 83 33 21 00 40 22 D3 EF -> @
$ 83 33 21 80 F0 E4 FC FD -> @
$ 83 32 22 00 E0 64 06 60 -> @
$ 83 33 22 80 DD 12 03 B8 -> @
$ 83 33 23 00 2B F6 90 01 -> @
$ 83 33 23 80 FB 12 2D 6E -> @
$ 83 32 24 00 AF 10 E5 AE -> @
$ 83 33 24 80 40 80 90 29 -> @
$ 83 33 25 00 80 FB 30 06 -> @
$ 83 33 25 80 80 03 12 35 -> @
$ 83 32 26 00 60 07 E4 FB -> @
$ 83 33 26 80 33 78 02 C3 -> @
$ 83 33 27 00 7F 04 7A 02 -> @
$ 83 33 27 80 D0 03 D0 02 -> @
$ 83 32 28 00 1C 12 28 3F -> @
$ 83 33 28 80 90 03 B3 E0 -> @
$ 83 33 29 00 12 33 E9 80 -> @
$ 83 33 29 80 89 30 05 1D -> @
$ 83 32 2A 00 EA 41 02 E2 -> @
$ 83 33 2A 80 7F FF 22 E4 -> @
$ 83 33 2B 00 94 04 50 59 -> @
$ 83 33 2B 80 03 B8 74 FF -> @
$ 83 32 2C 00 90 01 DD 02 -> @
$ 83 33 2C 80 CF E0 FB 12 -> @
$ 83 33 2D 00 02 9F 12 03 -> @
$ 83 33 2D 80 F5 83 EE F0 -> @
$ 83 32 2E 00 EF F0 AA 06 -> @
$ 83 33 2E 80 04 08 7B FF -> @
$ 83 33 2F 00 06 3A 78 3D -> @
$ 83 33 2F 80 7E 00 7F 02 -> @
$ 83 32 30 00 A3 EF F0 C2 -> @
$ 83 33 30 80 60 3A A2 AF -> @
$ 83 33 31 00 F5 A7 22 90 -> @
$ 83 33 31 80 E4 F0 90 01 -> @
$ 83 32 32 00 E5 12 39 C1 -> @
$ 83 33 32 80 02 7F 47 12 -> @
$ 83 33 33 00 12 32 0E 02 -> @
$ 83 33 33 80 B9 A3 E0 FE -> @
$ 83 32 34 00 AF 20 E3 F3 -> @
$ 83 33 34 80 D0 E0 32 EF -> @
$ 83 33 35 00 03 4F 7F 00 -> @
$ 83 33 35 80 02 C8 E0 F5 -> @
$ 83 32 36 00 D3 22 8D 82 -> @
$ 83 33 36 80 30 03 0A 90 -> @
$ 83 33 37 00 80 02 7E 20 -> @
$ 83 33 37 80 75 A7 20 43 -> @
$ 83 32 38 00 1F EE 60 0B -> @
$ 83 33 38 80 37 40 7B FF -> @
$ 83 33 39 00 22 75 AE 91 -> @
$ 83 33 39 80 AF AF 22 75 -> @
$ 83 32 3A 00 75 A7 20 75 -> A
$ 83 33 3A 80 02 30 5B 31 -> A
$ 83 33 3B 00 30 5B 31 0B -> A
$ 83 33 3B 80 A7 03 AC C6 -> A
$ 83 32 3C 00 11 5C A4 74 -> A
$ 83 33 3C 80 00 40 C4 10 -> A
$ 13 33 3D 00 D5 FF 3C E9 -> A
$ 07 34 00 00 3D 0F CA C0 -> C
$ 04 33 00 00 02 -> @
$ 03 36 00 00 -> @

Download complete with [ 8 ] errors`

Thread 58 (2017-09-03):

adding basic ssh/pgp support

acornejo, 2017-09-03:
It seems this chip provides 10kb of read/write eeprom memory that could be used to store data.

If u2f zero allowed the user to write access to write just a few of those (say 4kb), then one could store a master gpg key (or ssh key) in this key as well.

This would make the u2f-zero the one stop shop for all our crypto needs (not quite a openpgp card but almost as good).

The interface could be simple, say press the button for few seconds and the usb devices disconnects and when it reconnects it presents itself as a regular USB hard drive.

Of course, I am not familiar with this particular processor or the u2fzero firmware, so this may not be feasible.

Thoughts?

conorpp, 2017-09-03:
The eeprom is mostly all used by the firmware already so that probably wouldn't be feasible.  An alternative would be to just upgrade to another EFM8 chip with more flash.

Closed 2017-11-24.

Thread 60 (2017-10-19):

Secure Element

Immortalin, 2017-10-19:
Is U2F zero affected by any of the recent bugs in popular secure elements?

rickard-von-essen, 2017-10-19:
If you are referring to [CVE-2017015361](https://crocs.fi.muni.cz/public/papers/rsa_ccs17), that only concerns RSA generation on the secure element and [ATECC508A](http://ww1.microchip.com/downloads/en/DeviceDoc/Atmel-8923S-CryptoAuth-ATECC508A-Datasheet-Summary.pdf) doesn't support that.

Closed 2017-10-20.

Thread 62 (2017-11-03):

Gerber files

annacruz, 2017-11-03:
Hey there's a way to generate gerber files?

vojnovski, 2017-11-19:
Have a look here: http://docs.kicad-pcb.org/stable/en/getting_started_in_kicad.html#generate-gerber-files. The rename target in the Makefile will shed light on what layers to generate.

Closed 2017-11-24.

Thread 64 (2017-11-13):

Unable to add second U2F Zero to Google account.

ryanpcmcquen, 2017-11-13:
I thought this was an issue with Google's U2F implementation, but after reporting it on their help forum, I have heard reports of others adding multiple keys of the same type to the same Google account.

Relevant link:
https://support.google.com/chromebook/forum/AAAAmKCdEusTYUH4OFdOnQ/?hl=en

conorpp, 2017-11-14:
There was an issue with U2F Zero not working correctly when multiple U2F tokens are registered to one account.  The issue has recently [been fixed](https://github.com/conorpp/u2f-zero/commit/255c520e016caee914cfa878514cb60a126e6e0b) but all stock on Amazon is currently affected.

If you purchased one on Amazon, send me an email and I can send you a new one.

ryanpcmcquen, 2017-11-14:
Thank you @conorpp. Do you have a PGP key?

conorpp, 2017-11-15:
@ryanpcmcquen  yes: https://pgp.mit.edu/pks/lookup?op=vindex&search=0x1442045251A28169

ryanpcmcquen, 2017-11-27:
@conorpp, will you close this when the Amazon stock is updated?

conorpp, 2017-11-27:
What is currently on Amazon is up-to-date/fixed but I'll leave the issue open for now in case others have the same issue.

ryanpcmcquen, 2017-11-29:
@conorpp, just to clarify, if I order one today from Amazon it will not have this issue?

conorpp, 2017-11-29:
@ryanpcmcquen That's correct, at least from the U.S. market.

conorpp, 2018-01-04:
@ibotty Can you register it at https://demo.yubico.com/u2f and open up the technical information and post it here?

ibotty, 2018-01-04:
I'll do so in a second, but just for reference: How can I get that information from the shell?

ibotty, 2018-01-04:
```
Registration Data
origin: https://demo.yubico.com
version: U2F_V2
challenge: kJh_sWagZzvVWBuszvkTiAVPeLs0G1M1VQGM8YdQsUY
appId: https://demo.yubico.com

Response Data
clientData: {"challenge":"kJh_sWagZzvVWBuszvkTiAVPeLs0G1M1VQGM8YdQsUY","origin":"https://demo.yubico.com","typ":"navigator.id.finishEnrollment"}
registrationData: 0504204222dac0fa1dbc4104fefe520f94ba7e40aae0d39df297c7014fe51ad8ecae656f9dd3645bcb5209259d9e686fa6e7555eed2fd6928841c0060566c4d9ab1c24778452bdc1c842790d16504fa90742cb048f45dabd8a23cc38ebafe16e816f7fe9ffc25e308201de30820185020100300a06082a8648ce3d040302307b310b3009060355040613025553310b300906035504080c0256413113301106035504070c0a426c61636b73627572673110300e060355040a0c07436f6e6f72436f3114301206035504030c0b636f6e6f72636f2e636f6d3122302006092a864886f70d0109011613636f6e6f72636f40636f6e6f72636f2e636f6d301e170d3137303230323232303432345a170d3137303330343232303432345a307c310b3009060355040613025553310b300906035504080c0256413113301106035504070c0a426c61636b73627572673111300f060355040a0c08553246205a65726f3114301206035504030c0b7532667a65726f2e636f6d3122302006092a864886f70d0109011613636f6e6f72636f40636f6e6f72636f2e636f6d3059301306072a8648ce3d020106082a8648ce3d03010703420004a1155e6372c345ec97c12ac2ba84f863f1ae6ff17d800402a19f8606e422a7c02be4e34461153efbd41324ec84b254ec5852910d55b19b3079f588dbf305839a300a06082a8648ce3d04030203470030440220205c9e1d0d57cc2f0b25f0971cbf398ea3b20f9c9771fbfe88f4f9a103134cb6022026eedaaed8bf7c93700fcd1a264c52fae386293350b17a21112c03398dfde256304402203a640e21aba2ce8313056c2a3c28c23e682185cf8f16b5980fd9fb8a318a835202207fc2f204052a8fb7e5061d93369725f40d80b63b7829d315c1c99a9e877bc92d

Attestation Certificate
Certificate:
    Data:
        Version: 1 (0x0)
        Serial Number: 0 (0x0)
    Signature Algorithm: ecdsa-with-SHA256
        Issuer: C=US, ST=VA, L=Blacksburg, O=ConorCo, CN=conorco.com/emailAddress=conorco@conorco.com
        Validity
            Not Before: Feb  2 22:04:24 2017 GMT
            Not After : Mar  4 22:04:24 2017 GMT
        Subject: C=US, ST=VA, L=Blacksburg, O=U2F Zero, CN=u2fzero.com/emailAddress=conorco@conorco.com
        Subject Public Key Info:
            Public Key Algorithm: id-ecPublicKey
                Public-Key: (256 bit)
                pub:
                    04:a1:15:5e:63:72:c3:45:ec:97:c1:2a:c2:ba:84:
                    f8:63:f1:ae:6f:f1:7d:80:04:02:a1:9f:86:06:e4:
                    22:a7:c0:2b:e4:e3:44:61:15:3e:fb:d4:13:24:ec:
                    84:b2:54:ec:58:52:91:0d:55:b1:9b:30:79:f5:88:
                    db:f3:05:83:9a
                ASN1 OID: prime256v1
    Signature Algorithm: ecdsa-with-SHA256
         30:44:02:20:20:5c:9e:1d:0d:57:cc:2f:0b:25:f0:97:1c:bf:
         39:8e:a3:b2:0f:9c:97:71:fb:fe:88:f4:f9:a1:03:13:4c:b6:
         02:20:26:ee:da:ae:d8:bf:7c:93:70:0f:cd:1a:26:4c:52:fa:
         e3:86:29:33:50:b1:7a:21:11:2c:03:39:8d:fd:e2:56
-----BEGIN CERTIFICATE-----
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
4lY=
-----END CERTIFICATE-----
```

conorpp, 2018-01-06:
This is an older version key.  I recalled my whole U.S. inventory and shipped an updated shipment but I guess Amazon may have failed to ship back some.  Email me your address and order-ID and I'll ship you another token.  Sorry for the mix-up.

If anyone else happens to get an old token from U.S. market, free feel to send me an email and I can work on getting you a new one.

ryanpcmcquen, 2018-01-06:
How do you get the technical information from a bash shell?

conorpp, 2018-01-06:
I'm not currently aware of a CLI tool that will print out U2F parameters.  One could be fashioned relatively easily using one of these libraries though:

https://github.com/Yubico/libu2f-host
https://github.com/Yubico/python-u2flib-host

ibotty, 2018-01-06:
I assume the other key is also from the old batch, at least it has the same characteristics. I will register it with yubico's testpage as well to be sure though. I will get in touch by mail. Thank you for your kindness.

ellis2323, 2018-03-27:
Hello,

I'm from france and have received an amazon u2f zero. Is this a key from the old batch ?

Registration Data
origin: https://demo.yubico.com
version: U2F_V2
challenge: IbJPqlu671ZlbJHb5ih4JaacwYAsXuiIOB-hOXRaA0A
appId: https://demo.yubico.com

Response Data
clientData: {"typ":"navigator.id.finishEnrollment","challenge":"IbJPqlu671ZlbJHb5ih4JaacwYAsXuiIOB-hOXRaA0A","origin":"https://demo.yubico.com","cid_pubkey":"unused"}
registrationData: 050485fd09b59022e4add20027b01b0e184932184ef445709095c3b3893063944bd8ec4711702e6afe182ee7cd91f99746cd99fed2bda5971bce3ec85ec957f568d424bb07eae738da65e361e1988ede54f5f4b2efc95c64511915c2008ddc771036cbf7948920308201de30820185020100300a06082a8648ce3d040302307b310b3009060355040613025553310b300906035504080c0256413113301106035504070c0a426c61636b73627572673110300e060355040a0c07436f6e6f72436f3114301206035504030c0b636f6e6f72636f2e636f6d3122302006092a864886f70d0109011613636f6e6f72636f40636f6e6f72636f2e636f6d301e170d3137303230323232303432345a170d3137303330343232303432345a307c310b3009060355040613025553310b300906035504080c0256413113301106035504070c0a426c61636b73627572673111300f060355040a0c08553246205a65726f3114301206035504030c0b7532667a65726f2e636f6d3122302006092a864886f70d0109011613636f6e6f72636f40636f6e6f72636f2e636f6d3059301306072a8648ce3d020106082a8648ce3d03010703420004a1155e6372c345ec97c12ac2ba84f863f1ae6ff17d800402a19f8606e422a7c02be4e34461153efbd41324ec84b254ec5852910d55b19b3079f588dbf305839a300a06082a8648ce3d04030203470030440220205c9e1d0d57cc2f0b25f0971cbf398ea3b20f9c9771fbfe88f4f9a103134cb6022026eedaaed8bf7c93700fcd1a264c52fae386293350b17a21112c03398dfde256304402204e7febc4e734f572468673a06c3b61b1783f959964263188a60a4b9d2a6e4410022052484d1c9770b295b3ef9d215ece0b143f2cf6e4c6b5abdda4051d957f29e56f

Attestation Certificate
Certificate:
    Data:
        Version: 1 (0x0)
        Serial Number: 0 (0x0)
    Signature Algorithm: ecdsa-with-SHA256
        Issuer: C=US, ST=VA, L=Blacksburg, O=ConorCo, CN=conorco.com/emailAddress=conorco@conorco.com
        Validity
            Not Before: Feb  2 22:04:24 2017 GMT
            Not After : Mar  4 22:04:24 2017 GMT
        Subject: C=US, ST=VA, L=Blacksburg, O=U2F Zero, CN=u2fzero.com/emailAddress=conorco@conorco.com
        Subject Public Key Info:
            Public Key Algorithm: id-ecPublicKey
                Public-Key: (256 bit)
                pub:
                    04:a1:15:5e:63:72:c3:45:ec:97:c1:2a:c2:ba:84:
                    f8:63:f1:ae:6f:f1:7d:80:04:02:a1:9f:86:06:e4:
                    22:a7:c0:2b:e4:e3:44:61:15:3e:fb:d4:13:24:ec:
                    84:b2:54:ec:58:52:91:0d:55:b1:9b:30:79:f5:88:
                    db:f3:05:83:9a
                ASN1 OID: prime256v1
    Signature Algorithm: ecdsa-with-SHA256
         30:44:02:20:20:5c:9e:1d:0d:57:cc:2f:0b:25:f0:97:1c:bf:
         39:8e:a3:b2:0f:9c:97:71:fb:fe:88:f4:f9:a1:03:13:4c:b6:
         02:20:26:ee:da:ae:d8:bf:7c:93:70:0f:cd:1a:26:4c:52:fa:
         e3:86:29:33:50:b1:7a:21:11:2c:03:39:8d:fd:e2:56
-----BEGIN CERTIFICATE-----
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
4lY=
-----END CERTIFICATE-----

conorpp, 2018-03-28:
Yes keys in Europe Amazon marketplace are affected :(

Thread 65 (2017-11-23):

General Question

athavan-mahen, 2017-11-23:
Hi this is going to be my first project so i have some questions

1, can i download the USB diagram so i can edit them

2, when you order it from dirtypcbs and when then ship it do they cut the excess board so it fits in the USB port and the keyhole already punched out or do we need to cut them

3, what is the difference between Non-panelized and panelized

Thank you in advance for answering my question

conorpp, 2017-11-24:
1.  USB diagram?

2.  Yes they will cut it according to how it is drawn in the gerbers, which is what is posted in the releases.  Keyhole is cut out.

3.  Here is a picture of a panelized set of PCBs
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

rickard-von-essen, 2017-11-24:
And here is panelized U2F Zero's. You get three on the same die instead of the non panelized one.

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

athavan-mahen, 2017-11-25:
hi conorpp
thanks for the fast reply what I meant by the USB diagram is the file name "u2f-zero-gerbers.zip" so i can try to make some changes

Thank you in advance for the reply

athavan-mahen, 2017-11-25:
Hi rickard-von-essen
Thank you for the fast message, I really appreciate it as this help me to get a visual of the printed board
Thank you

conorpp, 2017-11-26:
You can use Kicad to edit the PCB layout and regenerate the gerbers

athavan-mahen, 2017-11-26:
Hi Conorpp where can I download the file for the PCB so I can edit them '
Thanks you

conorpp, 2017-11-26:
You can download the source using git or just download everything as a zip from the [repo page](https://github.com/conorpp/u2f-zero).

Then open "hardware/u2f-zero.pro" in Kicad.

conorpp, 2018-01-04:
Hope you got everything you needed, feel free to email me if you have more questions.

Closed 2018-01-04.

Thread 66 (2017-11-23):

Prevent extraction of secret keys

artemist, 2017-11-23:
Currently, the ECC keys calculated with the HMAC of the secret and the handle are extractable by recording the I2C traffic between the EFM8UB1 and the ATECC508A. The code that calculates and transfers the handle-specific private key is here:
https://github.com/conorpp/u2f-zero/blob/36c9f9ecd50a68322fd60f9ab06b40a4cbacb38d/firmware/src/u2f_atecc.c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

There are a few options to fix this:
* Change the ATECC508A configuration to not allow the results of the HMAC to be sent to the chip. I am not sure if this is possible, since I don't have the datasheet, as it is under NDA.
* If that is not possible, use a compatible chip from the ATECC line which is able to. I do not know if this exists, again because of the NDA issue.
* Change the Readme to make this more clear. An attack would require knowing the app and handle ID, which requires login credentials, and physical possession of the key along with a SOIC clip and logic analyzer. This is outside many user's threat models.

I would recommend changing the readme for now, and preventing this attack later. I will attempt to get the datasheet for the ATECC508A to see if it is possible.

darconeous, 2017-11-23:
I would be surprised if the ATECC508A is capable of generating a private key from the output from an internal HMAC operation without the private key material making a round trip. (I must admit I'm puzzled as to why the industry insists on all parts like this have the data sheets released only under NDA, but I digress)

The fact that most (all?) of these devices are not even encapsulated makes it possible for this attack to be performed without physically damaging the token.

conorpp, 2017-11-24:
The  HMAC response (ATECC -> EFM8) is XOR'd with a [32-byte key](https://github.com/conorpp/u2f-zero/blob/master/firmware/src/cert.c#L30) (by the ATECC) that is generated at programming time and it known to both devices.  It is unmasked at [line 318](https://github.com/conorpp/u2f-zero/issues/66#L318) of your code snippet.

`atecc_privwrite` will similarly wrap it with a different [32-byte key](https://github.com/conorpp/u2f-zero/blob/master/firmware/src/cert.c#L28) and the ATECC will unwrap it.

So an adversary can only observe R ^ K on the I2C bus, where R is a fixed random number and K is a secret key.  I believe this is fine but I appreciate any feedback.

conorpp, 2017-11-24:
@darconeous Security IC manufacturers usually have implicit NDA and commercial requirements for who can use the ICs because if someone finds a flaw, it's _really_ expensive to fix.  I guess red tape can prolong the discovery of a flaw.  NXP is dealing with [this right now](https://www.theregister.co.uk/2017/11/03/estonian_e_id_lockdown/).

artemist, 2017-11-24:
Oh, I did not realize that RMASK and WMASK were generated per-device. I can't think of any attacks that would allow you to use K ^ R and K ^ W to get private keys assuming that HMAC is a PRF and the ECDLP holds. However, this does reduce the security to an attacker's inability to read from the MCU flash. I'll look into the documentation to see if there are any ways past the EFM8 flask lock.

darconeous, 2017-11-24:
Ah, I remember that mechanism now from when I was reviewing the algorithm. It seemed sufficient to me at the time. I'm embarrassed I forgot about that.

> Security IC manufacturers usually have implicit NDA and commercial requirements for who can use the ICs because if someone finds a flaw, it's really expensive to fix. I guess red tape can prolong the discovery of a flaw. Infineon is dealing with [this right now](https://www.theregister.co.uk/2017/11/03/estonian_e_id_lockdown/).

Of course, by prolonging the discovery of the flaw, they made it **much** more expensive than it would have been to fix otherwise.

Off topic, but my gut feeling is that there are two additional reasons:

* Pressure from governments for these companies to keep track of who knows how to use these chips effectively.
* Desire to avoid sharing detailed chip capabilities with competitors.

szszszsz, 2018-07-25:
Hi! Is this still valid? Masking with random rkey/wkey seems to be enough to protect from originally reported issue (extracting secrets via eavesdropping the I2C).

darconeous, 2018-07-26:
Resolved to my satisfaction. For what it's worth.

As long as there is no way for an attacker to control or guess the bits that are being wrapped with the XOR, then it seems safe.

Thread 67 (2017-11-29):

U2F Zero crashes

ad-m, 2017-11-29:
> U2F Zero
> A 1KiB ping message crashes this device (i.e. it stops responding to USB messages and needs to be unplugged and reinserted). Testing a corrupted key handle also crashes it and thus I wasn't able to run many tests.

https://www.imperialviolet.org/2017/10/08/securitykeytest.html

Thread 68 (2017-12-05):

Unable to generate registration challenge, error in transport layer (-2)

ybergner, 2017-12-05:
Getting this error while trying to set up keys using pamu2fcfg on a macbook pro. The u2f-zero is connected through a usb-c adapter, so that may be part of the problem. Device will not register with other web-based multi-factor authentication set-ups either.

```
$ pamu2fcfg
No U2F device available, please insert one now, you have 14 seconds
Device found!
bar: -[numbers] -[numbers] 8 7
Unable to generate registration challenge, error in transport layer (-2)
```

vasillalov, 2019-05-30:
I can confirm this with Fedora 30 and latest Titan Security Key

Thread 69 (2018-01-04):

Cannot get U2F Zero to work, no matter the OS or Browser used.

OkaUsagi, 2018-01-04:
I have tried many browsers, and windows as well as linux, with no color change on the LED. It just fades green, with no other color. Pressing the button does give me the blue color, but nothing happens on the U2F side. Any help on what may be wrong? Windows and linux both see it as a U2F Zero, so clearly it's partly working.

ad-m, 2018-01-04:
@OkaUsagi , Wireshark support USB sniffing. Do you can record & publish here session of broken U2F?

OkaUsagi, 2018-01-04:
Yes, i can.

[u2fzero.zip](https://github.com/conorpp/u2f-zero/files/1602282/u2fzero.zip)

conorpp, 2018-01-04:
Have you tried with more than one U2F Zero?

OkaUsagi, 2018-01-04:
Nope, I only ordered one.

OkaUsagi, 2018-01-04:
In addition, I can use the wink command via sudo on my Linux box and that works.

OkaUsagi, 2018-01-04:
But yeah, no luck in figuring out what's wrong on my end,

conorpp, 2018-01-06:
It's probably faulty.  Email me your address and I'll ship another to you.

Closed 2018-01-06.

Thread 72 (2018-01-16):

Bought two keys. Neither will work on my mac or windows machines.

LordPowerbang, 2018-01-16:
On the yubico tester website it just says "timed out" but it happens the instant I press the button. Have tried 2 keys on two operating systems with USB 2.0 and 3.0. Very confused.

Davidsg33k, 2018-01-16:
Hi LordPowerbang,
When did you order the keys?

It would seem there was an issue with some of them recently.  "I experienced the same issue with the two keys i received.

I bet you can send "conorpp" a message to see what can be done.
 "perhaps on amazon if you got it there"
"I have to wait for the return funding to show up before i can order replacements."

Hopeful i will have them soon been waiting since dec 28th to test these.

best of luck, seems the bad batch got us both   "here is looking forward to testing the good ones when they come..

best regards
David Gaspar

conorpp, 2018-01-17:
There was a small shipment of faulty tokens to Amazon in U.S..  I've since recalled it and replaced the inventory.

If you made an order sometime in December or first week of January, there's a chance it's faulty because of my bad shipment.

If this is the case, please email me your order ID or just send me a message through Amazon and I'll refund you.

Sorry about that!!

LordPowerbang, 2018-01-17:
Thanks, Conorpp. I just sent you a message through Amazon. Mine were indeed purchased on 12/27/17, and received them 1/2/18, so it sounds like I was in the right window. I'm glad you're on top of it! Thanks a bunch!

Closed 2018-02-03.

Thread 73 (2018-01-20):

U2F Zero key derivation algorithm could be explained in more detail

vojnovski, 2018-01-20:
Currently, without doing a full analysis of the code, the key derivation algorithm used is not evident.

Something akin to https://developers.yubico.com/U2F/Protocol_details/Key_generation.html might be a good addition to the documentation.

Furthermore, it might be good to explain that the u2f fob programming should be done on a secure environment as the master key is generated there and then subsequently copied to the EFM8 and the ATECC.

#38 and #66 talk about this as well, and resources from there can be reused for documentation.

vojnovski, 2018-01-20:
While here, couldn't the master key generation have been done on-device? RMASK/WMASK could then have been also calculated on-device and sent back to the client script, in order to be incorporated in the final firmware.

gdamjan, 2018-01-24:
or alternativly, just left in a know place on the flash memory to be reused by the firmware which could then be generic.

conorpp, 2018-01-26:
@vojnovski yes key generation could be done on the device instead.  The hardware number generator on the ATECC508 is cryptographically based on a tamper resistant seed.  So if how Atmel set that seed up was to get compromised somehow, than at least key generation would still be secure since other RNG numbers were mixed in at the start.  At least, that was what I was initially thinking.  A user's computer getting compromised during programming might be more likely :)

szszszsz, 2018-08-03:
Hi! Here is our work-in-progress attempt to document the process: [security_architecture.md](https://github.com/Nitrokey/nitrokey-fido-u2f-firmware/blob/documentation/doc/security_architecture.md). Any feedback appreciated!

_(except some of the source code references, it should be the same with U2F-Zero)_

Thread 75 (2018-03-12):

expand u2f-zero to include OpenPGP

nimbius, 2018-03-12:
How do we expand this project to include OpenPGP capability? If Yubikey can include OTP+OpenPGP surely u2f-zero can include an OpenPGP version either separate, or integrated with the existing device.

conorpp, 2018-03-14:
It wouldn't be feasible with the current version of U2F Zero since there's only 16 KB of program memory and most of it is used already for U2F application.

A future version could do this but the microcontroller would have to be upgraded.  I just created #76 for this.

Closed 2018-03-18.

Thread 76 (2018-03-14):

Upgrade microcontroller

conorpp, 2018-03-14:
I'm considering upgrading the microcontroller on U2F Zero to support more functionality.  Some features that would be nice:

- More program memory.
    - Makes room for bootloader, configuration functions, and application to all fit in same firmware and simplifies the setup/flashing process.  The current programming process could be greatly improved.
    - More room for other services.  PGP, encrypted storage, bitcoin wallet, etc.
    - Crypto could be implemented in software and DPA countermeasures could be added.  This is a double edged sword as it would become more vulnerable to software vulnerabilities.

- More interfaces
    - NFC and Bluetooth interfaces

A couple microcontrollers that I like:

- Silabs [Pearl Gecko](https://www.silabs.com/products/mcu/32-bit/efm32-pearl-gecko).  It has a lot of program memory and has hardware encryption peripherals built in, including 256 bit ECC.  I'm not aware of any other MCU with asymmetric crypto hardware that can be purchased without an NDA.  No U2F interfaces though.
- Nordic Semiconductor [nRF52840](https://www.nordicsemi.com/eng/Products/nRF52840).  Plenty of program memory and supports BLE and NFC.  The NFC cannot be powered from a reader though and would need a battery.  Bluetooth would need a battery anyways.  There are no ECC peripherals so crypto operations would need to be done in software or offloaded to something else.

Thoughts/comments/questions?

al177, 2018-03-19:
Would it make sense to switch to EFM8UB3 as a stopgap?  They are footprint compatible with UB1 and offers 40k flash and 3k RAM vs the 16/2 of the current part.  Development could go forward on keystore type applications without having to roll out new hardware.

YakBizzarro, 2018-04-27:
The Nordic Semiconductor nRF52840 datasheet claims that it embeds a ARM-CryptoCell-310 which should support ECC

conorpp, 2018-04-28:
I think EFM8UB3 could be a nice quick upgrade to U2F Zero.  I'm thinking about making an official upgrade to that.

I must have initially missed the nRF52840 CryptoCell.  That solves the crypto acceleration and even offers other asymmetric algorithms (RSA) which might provide more flexibility for FIDO 2.  I don't think it offers any sort of tamper resistance or private key readout to protect from exploited firmware.  But I still think it's a pretty nice option.

@thearkadia I agree, Bluetooth seems ideal.  The big potential pain I see is including a battery and having to keep it charged.  I'm going to start prototyping soon and hopefully get some power consumption numbers.

rmhrisk, 2018-04-28:
I have looked into the nRF52840, it provides only acceleration and no key protection or other security isolation concepts. That said it looks like a great platform if you don’t need that and want BT and NFC.

MaPePeR, 2018-04-28:
I would prefer nfc over Bluetooth because it can work without a battery.

So an open source version of [this reference implementation](https://community.nxp.com/docs/DOC-329535) would be the great.
> The USB/NFC reference design provides USB for Laptop and PC  access while the NFC interface enables mobile devices like cell phones and tablets.

conorpp, 2018-04-28:
AFAIK, ISO 14443/NFC ICs (the ones that can be powered just by the interface) are difficult to get a hold of.  Only sold to businesses with high enough volumes, NDAs, etc.  Getting one of  them to work with an open source project might be tricky and people wouldn't be able to purchase and program their own easily.  I don't know of any that you can just buy from a distributor.

I tried going through the NDA process for one of NXP's A7005 secure microcontrollers through Avnet but they never got back to me.  It might be worth trying again.

MaPePeR, 2018-05-04:
What about [LPC8N04FHI24E](https://www.mouser.de/ProductDetail/NXP-Semiconductors/LPC8N04FHI24E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)?

(I searched for ["NFC" ICs on Mouser](https://www.mouser.de/Semiconductors/Integrated-Circuits-ICs/_/N-6j73k?Keyword=nfc&FS=True) and don't know a lot about ICs/NFC, so this might be a stupid suggestion)

conorpp, 2018-05-05:
Nice find!  LPC8N04 family would work for passive operation.  The  ARM M0 core may be too lightweight for computing ECC signatures (sec256r1/P-256 for U2F) and would [take on the order of 1 second to compute 1 signature](https://csrc.nist.gov/csrc/media/events/lightweight-cryptography-workshop-2015/documents/presentations/session7-vincent.pdf).  I think that would be too long for normal NFC readers.

That's encouraging though, maybe there is an attainable ISO 14443 option out there.

MaPePeR, 2018-05-05:
I think we want to use a separate security IC for storing the key and doing the ecc calculations anyway.

I remember that during my search I found nfc ICs that could provide the gathered power. And that should be enough to power such a security IC or otherwise we wouldn't have non battery nfc keys already on the market.

MaPePeR, 2018-05-10:
The [NT3H1101W0FHKH](https://www.mouser.de/ProductDetail/NXP-Semiconductors/NT3H1101W0FHKH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) claims to provide "Energy harvesting functionality to power external devices (e.g. microcontroller) " and is ISO/IEC 14443 Type A compatible.

eric-appion, 2018-05-10:
I'm in favor of using the Nordic nRF52840. Contrary to the statement at the start of this thread, it DOES have hardware support for cryptography, including ECC.

ARM TrustZone Cryptocell 310 security subsystem:
* NIST SP800-90A and SP800-90B compliant random number generator
* AES-128: ECB,CBC,CMAC/CBC-MAC,CTR,CCM/CCM
* Chacha20/Poly1305 AEAD supporting 128- and 256-bit key size
* SHA-1, SHA-2 up to 256 bits
* Keyed-hash message authentication code (HMAC)
* RSA up to 2048-bit key size
* SRP up to 3072-bit key size
* ECC support for most used curves, among others P-256 (secp256r1) and Ed25519/Curve25519

I've been doing a lot of work lately with the earlier nRF52832, and have used the nRF52840 a little bit.

Back when this thread started, the nRF52840 was not yet in volume production, but it is now, and is in stock at distributors including Digi-Key.

conorpp, 2018-05-11:
The NT3H1101* datasheet reports that it can typically harvest 5 mA @ 2V of power from a normal mobile device NFC reader.  I wonder if this could power the nRF52840?  With all peripherals turned off except to do 1 hash and 1 ECC operation with the crypto cell.  The current datasheet doesn't seem to have good power consumption numbers yet.  Does this sound crazy?

al177, 2018-05-11:
nRF52832 runs down to 1.6V.  You could put in a supercap and gate power to the nRF52832 until it's charged above that level.  But SMT supercaps that would keep the nRF alive long enough to complete the transaction are either very expensive and small or moderately expensive and about the size of a coin cell.

It would make more sense to use a primary coin cell or tiny LiPo in and get some use out of the Bluetooth functionality as well.

JoaoPortugal, 2018-05-12:
I agree with the need of **NFC and Bluetooth**, but they need to be made such a way that **they need to be individually manually activated each time one wants to use that individual feature**.
(Always on NFC is the dumbest thing I ever seen and is available in all most all new debit and credit cards this days... and hackers/ criminals taking advantage of that is obviously a reality that this company's want to hide any way they can, including sueing tv show's and others to make sure the information doesn't get the general public has people could start demanding the governments to forbid this technology.)

**A rechargeable/ changeable battery that can be recharged by usb connection and that can be easily changed when no longer holds the charge needs also to be taken in account.**

**Since this technology is being changed from second factor of authentication to just the one and only way authentication is made I thing is necessary to review all the concept of a small device to something that can protect it self by requiring people to enter some sort of password before allowing to use** (note that fingerprint is not a password... should be something you know... not another thing you have/ you are)... otherwise anyone that gets to hold it physically (I'm thinking: boarder agents, people stealing, ...) can immediately impersonate the user... precisely what this technology should be preventing in first place! And without password protection or even some sort of derived private key that is created based on that password (something SQRL - Secure Quick Reliable Login uses to allow in their case to use the same private key in the same web site with multiple accounts... but this has the benefit to allow the user to personalize to its taste the "login" such that even if their private key is obtain people still can't enter on the web sites unless they know that information also) anyone can just use it... and that is not nice when is your first and only factor of authentication.

Something that is not in the specs but should be taking in account is the availability of other than NIST ECC curves since this are known to be weak ( https://safecurves.cr.yp.to ) better ones are for example Curve25519, Ed448-Goldilocks and for example E-521. This availability will allow third party's to develop a better and more secure authentication mechanism... I'm thinking Wordpress/ Drupal/ Joomla! and many others CMS's plug-ins for example.

MaPePeR, 2018-05-12:
> Since this technology is being changed from second factor of authentication to just the one and only way authentication is made I thing is necessary to review all the concept of a small device to something that can protect it self by requiring people to enter some sort of password before allowing to use

I don't see this happening. This device is designed to be a second factor. Adding a password prompt to it would only make it more cumbersome to use. Especially requiring more buttons on the device and the user to remember another password, which defeats the purpose.
I agree, that the device only should authenticate when the user is actively allowing it to function and not be always on, though.

>Something that is not in the specs but should be taking in account is the availability of other than NIST ECC curves since this are known to be weak
Even though i agree with that claim i don't think we can change that. FIDO U2F devices can only function, when they fulfill the standard. The usage of the weak curve is written into the standard, if i'm not mistaken.

conorpp, 2018-05-16:
I've been reading the FIDO2 spec regarding pin codes and there isn't a need to put a display and set of buttons on the device.  The platform/client assumes most of the burden of a pin.

A FIDO2 token (authenticator) supports having a pin code set on it (via the platform).  A platform will subsequently need to have the pin input to be able to register or authenticate to the authenticator.  Encryption, HMAC, shared secrets are used so that the pin isn't ever shared in the clear on the wire.  It's not clear to me what's stopping a thief from just setting a new pin code and using that, but I'm guessing the platform will have to be smart and require a password if the pin-code is changed.

jawnmon, 2018-06-02:
Have you looked at the Signet project so the device can also work as a password manager? https://www.crowdsupply.com/nth-dimension/signet

conorpp, 2018-06-03:
I think extra functionality like a password manager would be neat.  FIDO2 aims to replace passwords so I might be more interested in a host based password manager that just converts FIDO2 to a password for sites that haven't implemented it yet.

MaPePeR, 2018-06-03:
> It takes about 35 ms for either authenticate or register and draws about 10 mA from a 2.5V coin cell.

So you said earlier:
> The NT3H1101* datasheet reports that it can typically harvest 5 mA @ 2V of power from a normal mobile device NFC reader.

So do you have a conclusion now? Is that difference solvable with a capacitor for power storage?

For the [M24LR16E-R](https://www.mouser.de/datasheet/2/389/m24lr16e-r-1156105.pdf) there is more detailed information about the harvested energy:

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

dmazzella, 2018-06-05:
Have you see [stm32wb](http://www.st.com/en/microcontrollers/stm32wb-series.html?querycriteria=productId=SS1961)?

sbrl, 2018-07-21:
Should I wait on buying one of these until the new version is available, or buy one now?

NovaaRF, 2018-07-26:
Very excited for an nRF52 version!
Let me know if I can help on the layout/rf side.

> It takes about 35 ms for either authenticate or register and draws about 10 mA

This would be dwarfed by any sort of LED indications the user gets (likely 10mA over 300ms, before and after auth?)

Assuming some 600ms at 10mA, 10x a day + 2uA drain 24/7, that amounts to ~5mAh (LEDs) + 17.5mAh (drain)/year
A small 50mAh lithium primary cell doesn't seem terrible if it lasts a couple years.

conorpp, 2018-07-30:
@Immortalin can you elaborate what you mean?

marcelorodpinheiro, 2018-07-30:
What I found atractive in u2f zero was that  it was so inexpensive i could lose one and replace it with another exactly like my bike key or my house key. Buy a batch of 3 or 4 , register them together where needed, store at least one in a safe (aka socks drawer) and you are good to go.
How much is the new version expected to cost?
I dont see a budget open source fido2 compliant project any hobbist could do anywhere else but here, and that is why I want to contribute if possible.

Is there a roadmap with goals and milestone we want to achieve?
Examples:
- Comply to u2f AND fido2 (complaint to which parts?)
- Do optional feature X.
- Cost X$
- Budget and l33t versions

jans23, 2018-07-30:
>  EFM32 jade/pearl don't have USB so a EFM8UB1 can be used to cheaply bridge to USB.

I don't think this is true because [Tomu](https://github.com/im-tomu/tomu-hardware/) uses just an EFM32 without a separate USB bridge.

Immortalin, 2018-07-31:
https://lauri.xn--vsandi-pxa.com

https://developers.yubico.com/PIV/Guides/Certificate_authority.html

@cornorpp

Immortalin, 2018-07-31:
Preferably key-gen can be done solely on-key too but that's going to able backups difficult...

Immortalin, 2018-07-31:
https://dennis.silvrback.com/openssl-ca-with-yubikey-neo

Something like this.

This would be a killer function as most smartcards don't have CA features

al177, 2018-07-31:
@Immortalin The current design uses an ATECC508A.  Some of the discussion here is around micros that have integrated crypto to eliminate the need for a separate keystore.

As for EFM32 Jade/Pearl Gecko lacking a USB device interface, maybe this could be adapted for USB-LS HID: https://github.com/MarkDing/lufa-efm32

conorpp, 2018-07-31:
@Immortalin Yeah that sounds totally doable.  Could be implemented as a vendor custom command and then a custom script/program could used to load private keys or do signing.

NovaaRF, 2018-07-31:
RE the bluetooth capability--are you considering a real FCC certification, or just selling them as "development boards"? I wonder how chill they would be if there's a couple thousand coming through amazon

rkrasin, 2018-07-31:
@NovaaRF I am not affiliated with @conorpp, but I feel like a public forum is not the best place to discuss such matters.

gonzopancho, 2018-08-17:
@Immortalin I’m not sure why the focus is on the ATECC508, when the 608a is out.

Immortalin, 2018-08-17:
@gonzopancho annoying that it still doesn't support AES 256

conorpp, 2018-09-04:
@Zjemm Planning to open new project later this week.  I have a progress update here: https://conorpp.com/designing-solo-a-new-u2ffido2-token

Planning to support SSH / PGP keys :)

sbrl, 2018-09-12:
@Zjemm Or even gitter?

Zjemm, 2018-09-13:
@sbrl i'm not familiar with those :)
Matrix.org is nice because it's open-source / decentralized / quickly growing in the community, and lots more.
but its just a suggestion.

conorpp, 2018-09-13:
Open sourced the code!  Contributors are more than welcome.
https://github.com/SoloKeysSec/solo

Still working on the hardware :)

I opened some  new issues over there.  A recent chip I found was the SAM L11 which provides an impressive number of security features, low power, cheap.

sriharshaguthikonda, 2024-10-07:
I don't know if people have said it, but NRF 52840 dongle is a good choice.

Thread 77 (2018-03-16):

Static Password Storage

lbenedix, 2018-03-16:
Would it be possible to have a single password stored on the device which would be typed in when the button is pressed long?

conorpp, 2018-08-31:
This should be relatively easy to add.  I think it could be added as a custom U2F command, then updated with a python script.

Thread 78 (2018-03-22):

Firefox Quantum unable to authenticate with U2F-zero

GitHubMad, 2018-03-22:
Hello
On Windows 7 or 10, my U2F-zero works well with Chrome or FF 52 ESR + [U2F Support Add-on](https://addons.mozilla.org/fr/firefox/addon/u2f-support-add-on/) : Great !

But trying on FF 57 to 59 :
- **Registering works** on most of the [U2F sites](http://www.dongleauth.info/) I tested (often need to tweak UA to Chrome)
- But **Authent for login always fails** (either with UA Chrome or not) : I see FF sending many trial requests to the Key but none succeed

On my Firefox Quantum I activated **security.webauth.u2f** and I don't have any U2F Plug-In (as U2F support is now native and "U2F Support Add-on" is not available for Quantum).

Firefox Quantum is said to support only [FIDO U2F devices using Web Authentication APIs (as part of FIDO 2) versus FIDO U2F APIs](https://www.yubico.com/2017/11/how-to-navigate-fido-u2f-in-firefox-quantum/).

Does it mean U2F-zero is not compatible with FIDO 2 (and so, with Firefox) ?
Any hope it will be ?

I bought mine [here](https://www.amazon.fr/U2F-Zero-U2-F/dp/B01L9DUPK6) around Xmas.

NOTE: even FF ESR will soon run into the same trouble, as it will jump to FF 60 when available (in a few monthes).

galadran, 2018-05-10:
I've just upgraded to FF60 and I've run into exactly this issue. I can register my device correctly, both on the Firefox test [page](https://webauthn.bin.coffee/) and on Github, however on both pages I can't login.

Firefox sees the request and prompts me to press a button on the token, however pressing the button doesn't result in anything happening. The LED doesn't go orange like it does for a registration request, although sometimes it starts blinking green.

On Chrome, the U2FZero works perfectly.

Is there any fix for this this? I'd really like use my U2FZero with Firefox.

conorpp, 2018-05-10:
In the FIDO 2 spec, the transport protocols (e.g. USB, NFC) are pretty much
the same so U2F still works alongside FIDO 2.  That is, if U2F is
implemented.  I believe FF60 does not implement U2F despite it having FIDO
2.  That’s odd that the register works but not authenticate..

I’m working on a FIDO 2 implementation now and will hopefully have it out
soon.  Old U2F zero devices won’t work since they won’t have enough memory
but a pin compatible upgrade to the efm8ub3 chip might work out.

On Thu, May 10, 2018 at 6:42 AM Dennis Jackson <notifications@github.com>
wrote:

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

nextgenthemes, 2018-05-11:
@conorpp

> I believe FF60 does not implement U2F despite it having FIDO

There are several switches in the about:config that suggest otherwise. There is a switch for UF2 and a softoken switch that one demo tells you to switch on. I bought the U2FZero to work with Firefox and was under the impression that it will work. I did not get what was really new in 60 when the other then they enabled a switch to be turned on by default.

All I can say is I trail and errored my was through all this links on this page https://wiki.mozilla.org/Security/CryptoEngineering and actually had the blinking working and for the https://webauthn.io/ demo the registration actually works and logs me in at the same time but then the login fails.

I also have found something somewhere to enabled the some USB think on Ubuntu Linux and i am not sure if its even needed. I have found **ABSOLUTELY NOTHING** on the official homepage about anything. I am pretty disappointed with this because its a product that is being sold with no goto place what the actual state of things is what works and how to get it to work ... nothing. But I guess its me again being cheap. I love the open hardware and stuff but there should be some info out there.

I have just successfully tested the U2F demo in chromium on ubuntu 18.04. But this webauthn demo https://webauthn.bin.coffee/ fails with this

> NotSupportedError: The user agent does not implement a password store.

Not really feel right to do hours of research and trail error end up on Github.

I thought:

> Open Standard - Open Hardware - Webauthn is basically U2F 2.0 or something like that and read devices that support U2F will automatically work with webauthn

But I guess not. How about telling this to people before they purchase this device? How about putting any info up on the site?

I thought I buy something that just works. And how to make it work later? Firmware upgrade is possible? Did not found anything about that. Instead searching for this leads me to the wiki to build my own and "program" it. I am not sure what if this mixes building and flashing of a bought one or whatever its just confusing.

> Old U2F zero devices won’t work since they won’t have enough memory but a pin compatible upgrade to the efm8ub3 chip might work out.

Does that mean my device I just bought might be old and will just not work or i will need to purchase some chip and put in on there?

conorpp, 2018-05-11:
I've tested on FF60 on https://u2f.bin.coffee/ and Github (register and authenticate) with latest U2F firmware and it seems to work fine.

@galadran @nextgenthemes when did you acquire U2F Zero?

nextgenthemes, 2018-05-11:
@conorpp

> Amazon page

How about the homepage? I do not use Amazon and I bought it there.

>  I agree with you

OK great how about actually addressing my comment and replying to my questions? Most importantly: Will there be a firmware upgrade that I can apply that will fix this?

I will mail you for a refund for sure, this is not acceptable to me. With a heads up for sure but not like this. Should have bought some mainstream device and plug it on and be happy.

> when did you acquire U2F Zero?

Very recently. I just tested the demo you linked again and the reg work then for auth it blinks but pushing it will do nothing at all.

conorpp, 2018-05-11:
The European stock is out of date and suffers from a couple bugs discovered around the start of this year.  The current firmware (and U.S. sold devices) should not have any issues with Firefox.

I'm working to update EU stock soon.  I have a notice on the Amazon pages but nothing on https://u2fzero.ch/.  Sorry!

nextgenthemes, 2018-05-16:
And again not addressing anything I asked about. And there is another utterly crazy crazy email exchange going on with me and this @conorpp dude who seem to unable to comprehend anything and after I told him I bought a single device he insisted that I am a reseller and wants so replace some imaginary stock I have. Seriously unfit! Anyone reading this do not buy this shit device from this amateurish dude who cant even read emails. Not sure why this surprises me given the amount of dedication he showed here to actually answer things and that the website has zero info on anything ...

rickard-von-essen, 2018-05-16:
Wow! That was rude.

MaPePeR, 2018-05-16:
> There are several switches in the about:config that suggest otherwise.

These are switches for **experimental** features and are not guaranteed to work. :man_shrugging:
And Firefox not working correctly is not a U2Fzero-only problem anyway. It does not allow authentication with google with ANY U2F-device - regardless of who made/sold it, for example.
Firefox did not even try to support U2F until very very recently, so a device that is a lot older than the firefox support can not really be expected to work flawlessly with firefox, anyway.

Also you cannot really blame anyone besides yourself for buying something without doing research about it before. :man_shrugging:

> I have just successfully tested the U2F demo in chromium on Ubuntu 18.04.

So... you bought a product that works.

I'm pretty sure everyone here would be willing to try figure out, what your problem is and how to fix it, but the tone of your messages makes taking you seriously and communicating with you very very hard (at least for me).

*Disclaimer: Not associated with u2fzero/conorco/etc.*

nextgenthemes, 2018-05-16:
Yeah that how I roll. When there is a reason for it I tell the facts but that so "rude". I already got a down-vote on my very extensive https://github.com/conorpp/u2f-zero/issues/78#issuecomment-388244301 for pointing out facts. Got all just ignored by @conorpp but seems to be a trend online to just ignore and skip over things ... but not dare anyone demand anything form a product that is sold for money. No no be all nice a cuddly with people who show you nothing for what you could possible respect them for.

I am not saying I could do this better. That's why I am not doing it! I could compile a simple basic straight forward list of information I would expect to see on the website I am rally not feeling like helping out.

And just so nobody get this wrong its not about that there is a faulty batch out, that can happen. Its about *everything around it*. The fact that you can not update the firmware via USB, that you are not told this b4 you buy it, that I have not been taken seriously here from the start, despite him offering me a refund and a replacement I do not feel he is paying attention at all. Its looks like a amateurish alpha operation to me and I can not recommend anyone to buy it of the creator does not show more dedication but at the same time sells it as a ready product.

And that email exchange, its so crazy I still can't believe this ... but its all just me. I am so "rude".

@MaPePer

>> I have just successfully tested the U2F demo in chromium on Ubuntu 18.04.

> So... you bought a product that works.

So because It works in a browser thank you do not use I should be happy with it. Are you kidding me? Not even he thinks that he already told that there is a faulty batch out!

> I'm pretty sure everyone here would be willing to try figure out,

No one needs to figure anything out. I need a Arduino to just upgrade the firmware or just a new device that's it.

MaPePeR, 2018-05-16:
There is nothing rude about just telling facts. But that is not what you do.

> [...] but not dare anyone demand anything form a product that is sold for money.  No no be all nice a cuddly with people who show you nothing for what you could possible respect them for.

Being respectful to oneanother is one of the core principals of communicating between adults. You seem to disagree on that and require "proof" that someone is to be respected by you.

> The fact that you can not update the firmware via USB

(I think) it would be horrible insecure if that would be possible.

> that you are not told this b4 you buy it

because (at least to me) it seems obvious, that this "feature" would break the product. Also there is no place where it says, that you CAN do that, so you cannot really expect a feature that was never even advertised?

>  that I have not been taken seriously here from the start

You just wrote that you don't take anyone seriously and refuse to act like a decent human being, before they show you something "you could possible respect them for", but demand to be taken seriously... I hope you can realize how that is a problem.

> So because It works in a browser that I do not use I should be happy with it.

The browser you use did not include the feature you want to use as of very recently.

> its also not working with the newest and coming standard

You cannot expect something you buy, that is already a little bit older, to work flawlessly with the newest coming standard for which it was not made.

Buy a car today and complain that its not autonomous when autonomous cars become standard.

conorpp, 2018-05-16:
Thank you all for your comments but it's getting off topic so I'm going to lock and close this thread.  Feel free to open other issues that are related to the open source project.

For sales/refunds/product complaints, please use the new support page.  FAQ will be updated with common issues that come up.

https://u2fzero.com/#support

Closed 2018-05-16.

Thread 79 (2018-03-22):

USB connection stability: Suggestion for the 3D-printed case

GitHubMad, 2018-03-22:
When inserted in a USB connector, U2F-zero can move vertically, as the PCB is somehow thiner that the space in the plug. It results in some bad electrical contacts when we push the button.

We printed [this file](https://github.com/conorpp/u2f-zero/tree/master/hardware/case).
But it didn't solve this issue.
I glued some thick paper under the male USB connector, and it is much more stable.

I suggest the 3D file could add a thin plastic layer under the connector.
We couldn't prototype this idea, as we use OpenSCAD that doesn't open your source file format.

Thread 82 (2018-06-10):

unable to register

e3bo, 2018-06-10:
This could be user error, but I'm not able to register either of the 2 u2fzeros I just received last week from Amazon on either GitHub, Google, or https://u2f.bin.coffee/. On every registration attempt, the light never turns orange, although it goes from green to blue when I hold the button down. I've tried with Firefox 60 and Chromium 67 on Arch Linux, using all 3 USB ports on my laptop. It seems to me I have a similar problem to #69, which was attributed to faulty devices. However, I was wondering if someone could explain to me how I could confirm that, or suggest what I might be doing wrong.

conorpp, 2018-06-10:
When did you order them?  In the U.S.?

e3bo, 2018-06-10:
I ordered them on June 3 in the U.S.  They shipped on June 6. The return address on the shipping envelope is Lexington, KY.

I'm going to try using them in a Windows computer in a few minutes.

MaPePeR, 2018-06-10:
Just a very random guess: did you add ehe udev rule that is required to operate u2f devices on linux? (Not sure if they are added by default)

e3bo, 2018-06-10:
That was it. Thanks for your patient help. I looked at the wiki last night but somehow missed that. For anyone else with this problem, see instructions on this page:

https://github.com/conorpp/u2f-zero/wiki/Using-U2F-Token-on-Linux-(udev)

Closed 2018-06-10.

Thread 86 (2018-07-28):

Flashing of retail version

char32, 2018-07-28:
I wanted to flash a current version on a u2fkey.

What I tried is to bring a bought version of the u2fzero into a bootloader mode. But it does not seem to work.
Is it disabled?

Is there a manual on how to connect a programmer (like the SLSTK2000a or similar) to the key without soldering wires to it? I did not find anything in the wiki.

Thanks a lot! And keep up the great work :-)

char32, 2018-07-28:
Thanks for the fast answer! So the booloader is removed due to space issues. Makes sense.
But it should be possible to use a programmer, right? I just need to get the connection right.

Thanks again!

ad-m, 2018-07-28:
See https://github.com/conorpp/u2f-zero/wiki/Building-a-U2F-Token#using-a-programmer .

char32, 2018-07-28:
Thanks! I'll try to build something out of header connectors or so to get a stable connection between programmer and stick without soldering wires to the stick.

ad-m, 2018-07-28:
I'm not an electronics. Can you use some light glue / plasticine for that?

char32, 2018-07-29:
Yeah I am more on the software development side too :-) Good idea with the plasticine! I'll try that.
Something like https://www.segger.com/products/debug-probes/j-link/accessories/adapters/10-pin-needle-adapter/ would be perfect, but they are expensive.

rickard-von-essen, 2018-07-29:
I think I cut one of [these](https://eu.mouser.com/ProductDetail/798-A110PA254DSA71) and soldered together a cable.

Thread 87 (2018-07-29):

Toshiba DF5A5.6FU replacement?

ido1990, 2018-07-29:
Hi!
I got all the parts from my vendor (not Mouser or Digikey) except of the **Toshiba DF5A5.6FU**
I found few others and I'm not sure which one is the closest to the DF5A5.6FU and will work well with the u2f-zero:

1. DF**3**A5.6FU
2. DF5A5.6**L**FU
3. DF5A**6.8CFU**

Thanks!

conorpp, 2018-07-31:
If you look at datasheets for both DF5A5.6FU and DF5A5.6LFU, it seems that they are both largely the same.  The only difference I see if that DF5A5.6LFU has a low terminal capacitance, which is a good thing :).

ido1990, 2018-07-31:
Ok.
I didn't know if the low capacitance is good or bad.
Thank you!

Closed 2018-07-31.

Thread 90 (2018-08-13):

Replacement for 100 Ohm resistor?

dylmye, 2018-08-13:
Hi guys,

I'm looking to build a u2f zero for the first time. I'm buying components and I found that the CRCW0805100RFKEA seems to be out of stock everywhere - perhaps they've stopped selling this model? Either way, I'm looking to use the [Panasonic ERJ-6ENF1000V](https://eu.mouser.com/ProductDetail/667-ERJ-6ENF1000V) - it seems to have very similar specs. :)

Also, here's some Mouser alternative links for the products you only list a Mouser link:

- Cree LED: https://eu.mouser.com/ProductDetail/941-VBAFKACAEDH8B7A3
- Zener Diode: https://eu.mouser.com/ProductDetail/757-DF5A56FUTE85LF

Hope this helps for updating the Parts list page!

Thread 96 (2019-01-03):

Unable to register with any U2F device.

Jerry280989322, 2019-01-03:
I've been tring to make the U2F-zero interact with U2F-host(https://github.com/Yubico/python-u2flib-host),but it doesn't work any more. The result is as following:

~$ u2f-register -i reg.json http://localhost:8081

Touch the U2F device you wish to register...

Unable to register with any U2F device.

Is it because the slots is full?? or else? It troubles me a lot.I would be very thankful if someone could help me out.

conorpp, 2019-01-03:
what operating system and browser are you using?

Jerry280989322, 2019-01-03:
Ubuntu 18.04.1 LTS
No browser, just the command line.

conorpp, 2019-01-03:
did you set a udev rule?
https://github.com/conorpp/u2f-zero/wiki/Using-U2F-Token-on-Linux-(udev)

Jerry280989322, 2019-01-03:
> did you set a udev rule?
> https://github.com/conorpp/u2f-zero/wiki/Using-U2F-Token-on-Linux-(udev)

Oh god, I haven't do that.Thanks~

Jerry280989322, 2019-01-03:
Oh....I meet with another problem.There is no    70-u2f.rule    in my /etc/udev/rules.d, but a  70-snap.core.rules.
Did I miss someting?

conorpp, 2019-01-03:
You have to create the file

Jerry280989322, 2019-01-03:
OK~

Jerry280989322, 2019-01-03:
It still doesn't work... Besides, when I do the HID-test, it meet with a problem  as follows:
PASS(test_Idle())
PASS(test_Init())
PASS(test_BasicInit())
PASS(test_Unknown(U2FHID_SYNC))
PASS(test_InitOnNonBroadcastEchoesCID())
PASS(test_InitUnderLock())
PASS(test_InitSelfAborts())
PASS(test_InitOther())
PASS(test_OptionalWink())
PASS(test_Lock())
PASS(test_Echo())
CHECK_LE fail at test_LongEcho[148]:sent > .075: 已放弃

conorpp, 2019-01-03:
yes it's a little slow, that particular test shouldn't be an issue.  What about the U2F test?

Jerry280989322, 2019-01-03:
> yes it's a little slow, that particular test shouldn't be an issue. What about the U2F test?

Oh,I haven't try it yet. I will try it after lunch.  :)

Jerry280989322, 2019-01-03:
Here is the result of U2FTest, it seems that there is some problems with enroll:

$ sudo ./U2FTest /dev/hidraw6
PASS(check_Compilation())
PASS(test_Version())
PASS(test_UnknownINS())
PASS(test_WrongLength_U2F_VERSION())
PASS(test_WrongLength_U2F_REGISTER())
PASS(test_BadCLA())
PASS(test_Enroll(0x6985))

Touch device and hit enter..

CHECK_EQ fail at test_Enroll[134]:expectedSW12 != U2Fob_apdu(device, 0, U2F_INS_REGISTER, U2F_AUTH_ENFORCE, 0, string(reinterpret_cast<char*>(&regReq), sizeof(regReq)), &rsp): 已放弃

conorpp, 2019-01-04:
Where/when did you get your token?

Jerry280989322, 2019-01-04:
about 2016.11    I guess.  It was given by my friend.

Jerry280989322, 2019-01-04:
when I try to test it in the ,[ https://demo.yubico.com/u2f?tab=register](url)，it returns that

Registration failed!
Make sure you have a U2F device connected, and try again.

 Traceback (most recent call last):
  File "/root/python-u2flib-server-demo/examples/yubiauth_server.py", line 161, in __call__
    raise Exception("FIDO Client error: %s" % error)
Exception: FIDO Client error: 1 (OTHER ERROR)

 And during the time, the LED on the board turn red from green , what does the red light mean?

conorpp, 2019-01-06:
There was an issue with a particular U2F "CHECK-ONLY" command, which is used to see if a key handle is owned by a U2F token.  Needed to be used when there are multiple U2F tokens, some services always use it first.  This has since been fixed but it's likely your token has this problem :(

Jerry280989322, 2019-01-06:
> There was an issue with a particular U2F "CHECK-ONLY" command, which is used to see if a key handle is owned by a U2F token. Needed to be used when there are multiple U2F tokens, some services always use it first. This has since been fixed but it's likely your token has this problem :(
>
> You can exchange it with the channel you or your friend got it from.

You mean the old version of firmware  has this problem and it has been fixed in the latest firmware now?

conorpp, 2019-01-06:
yes

Jerry280989322, 2019-01-08:
Can I update the firmware into the u2f-zero by myself?
I don't have a programmer so I have to use the bootloader method.when I use the command "python client.py bootloader"   ,it turns out that

~/u2f-zero/tools/u2f_zero_client$ python client.py bootloader
opened  None
If this device has an enabled bootloader, the LED should be turned off.

But I found that the LED is still on(green). Am I do the right steps if I want to change the u2f-zero into bootloader mod ? @conorpp

Thread 103 (2021-05-07):

Port for Raspberry PI pico

bubundas17, 2021-05-07:
Can it be ported to raspberry pi pico?
As the board is widely available and at a cheap cost too.
It would be very good if somebody can get it working on pi pico.

rickard-von-essen, 2021-05-07:
But the RP2040 isn't a HSM.

bubundas17, 2021-05-07:
> But the RP2040 isn't a HSM.
Yap raspberry pi pico definitely not made for storing keys securely.

It will be mostly helpful for tinkering and playing with the u2f protocol. And as this PI pico board is easily available and do not require a custom PCB or programmer like this project.

bubundas17, 2021-05-07:
Thanks.

Thread 104 (2021-12-28):

U2F Zero fails to authenticate on Fedora 35

quignogs, 2021-12-28:
I have a U2F zero, delivered in Feb 2018 to the UK. It may be a bad one, but in 2018 I successfully registered it with Google 2FA on Firefox and used the key several times to authenticate over the next year or so.

I haven't used the key since then, but yesterday I tried to set up pam-u2f for login.

Registering works fine:  `pamu2fcfg -u zoom >> /etc/u2fkeys`.
The key's led flashed, I pressed the button and the output seems OK.
But login authentication failed.

I tried to use the key to authenticate to Google yesterday; that now doesn't now work. Earlier today, I successfully registered the key for 2FA with github and on my personal nextcloud instance. Registration works fine, but Firefox won't authenticate. When I try, Firefox pops up a window which says `<server> wants to authenticate you using a registered security key. You can connect and authorise one now, or cancel.` But I don't get an option to use the key, only the cancel button.

So it seems that both Firefox and pam are doing the same thing, which suggests that the cause lies in either user space libraries or the kernel.

I can reproduce the login problem with pamtester: [here is a redacted debug log](https://github.com/conorpp/u2f-zero/files/7786434/pamtest.txt). I'm removing all the sensitive data, but what I see looks convincing.

The hid-u2fzero module loads OK. I see no problem with e.g. selinux denying access to anything: [this is what syslog sees while pamtester runs](https://github.com/conorpp/u2f-zero/files/7786516/pamsyslog.txt). It would seem that there is an I/O problem, but only after a couple of exchanges are completed. I understand that the problem with the bad batch was with command 0x07; I see only 0x06 and 0x03.

Ideas? Is there a sanity check for U2F Zero which can pin down where the problem is? I assume that pam-u2f hasn't suddenly stopped working and that Yubi or Nitro keys are probably OK, but I don't have either to hand for comparison. None of the bad key workarounds for pam-u2f such as nodetect, cue or manual affect this failure.

```
$ firefox --version
Mozilla Firefox 95.0.2
$ uname -r
5.15.11-200.fc35.x86_64
$ rpm -qa|grep u2f
pam-u2f-1.2.0-2.fc35.x86_64
pamu2fcfg-1.2.0-2.fc35.x86_64
```
