conorpp/u2f-zero/firmware/src/u2f-atecc.c

/*
 * Copyright (c) 2016, Conor Patrick
 * All rights reserved.
 *
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
 * THIS SOFTWARE IS PROVIDED BY THE COPYRIGHT HOLDERS AND CONTRIBUTORS "AS IS" AND
 * ANY EXPRESS OR IMPLIED WARRANTIES, INCLUDING, BUT NOT LIMITED TO, THE IMPLIED
 * WARRANTIES OF MERCHANTABILITY AND FITNESS FOR A PARTICULAR PURPOSE ARE
 * DISCLAIMED. IN NO EVENT SHALL THE COPYRIGHT OWNER OR CONTRIBUTORS BE LIABLE FOR
 * ANY DIRECT, INDIRECT, INCIDENTAL, SPECIAL, EXEMPLARY, OR CONSEQUENTIAL DAMAGES
 * (INCLUDING, BUT NOT LIMITED TO, PROCUREMENT OF SUBSTITUTE GOODS OR SERVICES;
 * LOSS OF USE, DATA, OR PROFITS; OR BUSINESS INTERRUPTION) HOWEVER CAUSED AND
 * ON ANY THEORY OF LIABILITY, WHETHER IN CONTRACT, STRICT LIABILITY, OR TORT
 * (INCLUDING NEGLIGENCE OR OTHERWISE) ARISING IN ANY WAY OUT OF THE USE OF THIS
 * SOFTWARE, EVEN IF ADVISED OF THE POSSIBILITY OF SUCH DAMAGE.

 * The views and conclusions contained in the software and documentation are those
 * of the authors and should not be interpreted as representing official policies,
 * either expressed or implied, of the FreeBSD Project.
 */

#include "app.h"
#ifndef U2F_DISABLE
#include "bsp.h"
#include "u2f.h"
#include "u2f_hid.h"
#include "eeprom.h"
#include "atecc508a.h"

struct key_handle
{
	uint8_t index;
	uint8_t entropy[3];
};

struct key_storage_header
{
	uint8_t num_keys;
	uint16_t valid_keys;
	uint8_t num_issued;
} key_store;

#define U2F_NUM_KEYS 			U2F_ATTESTATION_KEY_SLOT
#define U2F_KEYS_ADDR			(0xF800)
#define U2F_KEY_ADDR(k)			(U2F_KEYS_ADDR + ((k)*U2F_KEY_HANDLE_SIZE))


#define IS_KEY_VALID(mask,key)	((~mask) & (1<<key))

static struct u2f_hid_msg res;
static uint8_t* resbuf = (uint8_t*)&res;
static uint8_t resseq = 0;
static uint8_t serious = 0;

// 0 if same, 1 otherwise
static uint8_t key_same(struct key_handle * k1, struct key_handle * k2)
{
	uint8_t i;
	if (k1->index != k2->index) return 1;
	for (i=0; i < U2F_KEY_HANDLE_SIZE-1; i++)
	{
		if (k1->entropy[i] != k2->entropy[i])
			return 1;
	}
	return 0;
}

static void flush_key_store()
{
	eeprom_erase(U2F_EEPROM_CONFIG);
	eeprom_write(U2F_EEPROM_CONFIG, (uint8_t* )&key_store, sizeof(struct key_storage_header));
}

int8_t u2f_wipe_keys()
{
	uint8_t presses = 5;
	serious = 1;
	while(presses--)
	{
		if (u2f_get_user_feedback() != 0)
		{
			goto nowipe;
		}
	}

	// wipe
	serious = 0;
	eeprom_erase(U2F_EEPROM_CONFIG);
	u2f_init();
	return 0;

	nowipe:
	serious = 0;
	return -1;
}

void u2f_init()
{
	int8_t i,ec;
	struct atecc_response res;

	eeprom_read(U2F_EEPROM_CONFIG, (uint8_t* )&key_store, sizeof(struct key_storage_header));

	// initialize key handles
	if (key_store.num_keys != U2F_NUM_KEYS)
	{
		watchdog();


		for (i=0; i < U2F_NUM_KEYS; i++)
		{
			watchdog();
			ec = atecc_send_recv(ATECC_CMD_RNG,ATECC_RNG_P1,ATECC_RNG_P2,
							NULL, 0,
							appdata.tmp,
							sizeof(appdata.tmp), &res);
			if (ec != 0)
			{
				u2f_printb("REDO! REDO! ",2,i,-ec);
				eeprom_erase(U2F_EEPROM_CONFIG);
				// reset
				reboot();
			}
			res.buf[0] = i+1;


			eeprom_write(U2F_KEYS_ADDR + i * U2F_KEY_HANDLE_SIZE,
							res.buf, U2F_KEY_HANDLE_SIZE);
		}

		key_store.num_keys = U2F_NUM_KEYS;
		key_store.valid_keys = 0;
		key_store.num_issued = 0;
		flush_key_store();

	}

}

void u2f_response_writeback(uint8_t * buf, uint16_t len)
{
	u2f_hid_writeback(buf, len);
}

void u2f_response_flush()
{
	watchdog();
	u2f_hid_flush();
}

void u2f_response_start()
{
	watchdog();
}

int8_t u2f_get_user_feedback()
{
	uint32_t t;
	u2f_delay(1);
	t = get_ms();
	while(U2F_BUTTON_IS_PRESSED()){}
	while(!U2F_BUTTON_IS_PRESSED())
	{
		// turn red
		if (serious)
		{
			rgb_hex(U2F_DEFAULT_COLOR_ERROR);
		}
		else
		{	// yellow
			rgb_hex(U2F_DEFAULT_COLOR_INPUT);
		}
		if (get_ms() - t > 10000)
			break;
		watchdog();
	}

	if (U2F_BUTTON_IS_PRESSED())
	{
		rgb_hex(U2F_DEFAULT_COLOR_INPUT_SUCCESS);
	}
	else
	{
		rgb_hex(U2F_DEFAULT_COLOR_ERROR);
		return 1;
	}

	return 0;
}

static uint8_t shabuf[70];
static uint8_t shaoffset = 0;
static struct atecc_response res_digest;

void u2f_sha256_start()
{
	shaoffset = 0;
	atecc_send_recv(ATECC_CMD_SHA,
			ATECC_SHA_START, 0,NULL,0,
			appdata.tmp, sizeof(appdata.tmp), NULL);
}


void u2f_sha256_update(uint8_t * buf, uint8_t len)
{
	uint8_t i = 0;
	watchdog();
	while(len--)
	{
		shabuf[shaoffset++] = *buf++;
		if (shaoffset == 64)
		{
			atecc_send_recv(ATECC_CMD_SHA,
					ATECC_SHA_UPDATE, 64,shabuf,64,
					appdata.tmp, sizeof(appdata.tmp), NULL);
			shaoffset = 0;
		}
	}
}


void u2f_sha256_finish()
{
	atecc_send_recv(ATECC_CMD_SHA,
			ATECC_SHA_END, shaoffset,shabuf,shaoffset,
			shabuf, sizeof(shabuf), &res_digest);
}


int8_t u2f_ecdsa_sign(uint8_t * dest, uint8_t * handle)
{
	struct atecc_response res;
	struct key_handle k;
	uint16_t keyslot = (uint16_t)((struct key_handle *)handle)->index;
	watchdog();
	if (keyslot > U2F_NUM_KEYS)
	{
		return -1;
	}
	if (keyslot == 0)
	{
		keyslot = U2F_ATTESTATION_KEY_SLOT;
	}
	else
	{
		keyslot--;
	}

	atecc_send_recv(ATECC_CMD_SIGN,
			ATECC_SIGN_EXTERNAL, keyslot, NULL, 0,
			appdata.tmp, sizeof(appdata.tmp), &res);

	if (keyslot != U2F_ATTESTATION_KEY_SLOT)
	{
		eeprom_read(U2F_KEY_ADDR(keyslot), (uint8_t* )&k, U2F_KEY_HANDLE_SIZE);

		if (key_same((struct key_handle *)handle, &k) != 0)
		{
			return -1;
		}
	}

	memmove(dest, res.buf, 64);

	return 0;
}

// bad if this gets interrupted
int8_t u2f_new_keypair(uint8_t * handle, uint8_t * pubkey)
{
	struct atecc_response res;
	struct key_handle k;
	uint8_t keyslot = key_store.num_issued;
	if (keyslot > U2F_NUM_KEYS-1)
	{
		app_wink(U2F_DEFAULT_COLOR_WINK_OUT_OF_SPACE);
		return -1;
	}
	watchdog();
	atecc_send_recv(ATECC_CMD_GENKEY,
			ATECC_GENKEY_PRIVATE, keyslot, NULL, 0,
			appdata.tmp, sizeof(appdata.tmp), &res);

	memmove(pubkey, res.buf, 64);

	eeprom_read(U2F_KEY_ADDR(keyslot), (uint8_t* )&k, U2F_KEY_HANDLE_SIZE);
	if (k.index-1 != keyslot)
	{

		k.index = keyslot;
		set_app_error(ERROR_BAD_KEY_STORE);
	}
	memmove(handle, &k, U2F_KEY_HANDLE_SIZE);
	key_store.num_issued++;
	flush_key_store();

	return 0;
}

int8_t u2f_load_key(uint8_t * handle, uint8_t len)
{
	struct key_handle k;
	uint8_t keyslot = handle[0]-1;
	if (keyslot >= U2F_NUM_KEYS)
	{
		return -1;
	}
	eeprom_read(U2F_KEY_ADDR(keyslot), (uint8_t* )&k, U2F_KEY_HANDLE_SIZE);

	if (key_same((struct key_handle *)handle, &k) != 0)
	{
		return -1;
	}
	return 0;
}

uint32_t u2f_count()
{
	struct atecc_response res;
	atecc_send_recv(ATECC_CMD_COUNTER,
			ATECC_COUNTER_INC, ATECC_COUNTER0,NULL,0,
			appdata.tmp, sizeof(appdata.tmp), &res);
	return le32toh(*(uint32_t*)res.buf);
}

extern uint16_t __attest_size;
extern code char __attest[];

uint8_t * u2f_get_attestation_cert()
{
	return __attest;
}

uint16_t u2f_attestation_cert_size()
{
	return __attest_size;
}

void set_response_length(uint16_t len)
{
	u2f_hid_set_len(len);
}

#endif
