conorpp/u2f-zero/firmware/src/bsp.c

/*
 * Copyright (c) 2016, Conor Patrick
 * All rights reserved.
 *
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
 * THIS SOFTWARE IS PROVIDED BY THE COPYRIGHT HOLDERS AND CONTRIBUTORS "AS IS" AND
 * ANY EXPRESS OR IMPLIED WARRANTIES, INCLUDING, BUT NOT LIMITED TO, THE IMPLIED
 * WARRANTIES OF MERCHANTABILITY AND FITNESS FOR A PARTICULAR PURPOSE ARE
 * DISCLAIMED. IN NO EVENT SHALL THE COPYRIGHT OWNER OR CONTRIBUTORS BE LIABLE FOR
 * ANY DIRECT, INDIRECT, INCIDENTAL, SPECIAL, EXEMPLARY, OR CONSEQUENTIAL DAMAGES
 * (INCLUDING, BUT NOT LIMITED TO, PROCUREMENT OF SUBSTITUTE GOODS OR SERVICES;
 * LOSS OF USE, DATA, OR PROFITS; OR BUSINESS INTERRUPTION) HOWEVER CAUSED AND
 * ON ANY THEORY OF LIABILITY, WHETHER IN CONTRACT, STRICT LIABILITY, OR TORT
 * (INCLUDING NEGLIGENCE OR OTHERWISE) ARISING IN ANY WAY OUT OF THE USE OF THIS
 * SOFTWARE, EVEN IF ADVISED OF THE POSSIBILITY OF SUCH DAMAGE.

 */
#include <SI_EFM8UB1_Register_Enums.h>
#include <efm8_usb.h>
#include <stdarg.h>
#include <stdio.h>
#include "app.h"
#include "bsp.h"


void u2f_delay(uint32_t ms) {
	uint32_t ms_now = get_ms();
	while((get_ms() - ms_now) < ms)
	{
		watchdog();
	}
}

void usb_write(uint8_t* buf, uint8_t len)
{
	uint8_t errors = 0;
	while (USB_STATUS_OK != (USBD_Write(EP1IN, buf, len, false)))
	{
		u2f_delay(2);
		if (errors++ > 30)
		{
			set_app_error(ERROR_USB_WRITE);
			break;
		}
	}
}


// Painfully lightweight printing routines
#ifdef U2F_PRINT

void putf(char c)
{
	uint8_t i;
	SBUF0 = c;
	// Blocking delay that works for 115200 baud on this device (<1ms)
	for (i=0; i<200; i++){}
	for (i=0; i<200; i++){}
	for (i=0; i<190; i++){}
	watchdog();
}


void dump_hex(uint8_t* hex, uint8_t len)
{
	uint8_t i;
	for (i=0 ; i < len ; i++)
	{
		if (hex[i]<0x10)
		{
			putf('0');
		}
		u2f_putb(hex[i]);
	}
	u2f_prints("\r\n");
}


void u2f_prints(char* d)
{
	while(*d)
	{
		// UART0 output queue
		putf(*d++);
	}
}

static void int2str_reduce_n(char ** snum, uint32_t copy, uint8_t n)
{
    do
    {
        copy /= n;
    }while(copy);
}


static const char * __digits = "0123456789abcdef";
static char __int2str_buf[9];

static void int2str_map_n(char ** snum, uint32_t i, uint8_t n)
{
    do
    {
        *--*snum = __digits[i % n];
        i /= n;
    }while(i);
}

#define dint2str(i)     __int2strn(i,10)
#define xint2str(i)     __int2strn(i,16)

char * __int2strn(int32_t i, uint8_t n)
{
    char * snum = __int2str_buf;
    if (i<0) *snum++ = '-';
    int2str_reduce_n(&snum, i, n);
    *snum = '\0';
    int2str_map_n(&snum, i, n);
    return snum;
}

void u2f_putd(int32_t i)
{
	u2f_prints(dint2str((int32_t)i));
}

void u2f_putx(int32_t i)
{
	u2f_prints(xint2str(i));
}

static void put_space()
{
	u2f_prints(" ");
}
static void put_line()
{
	u2f_prints("\r\n");
}

void u2f_printd(const char * tag, uint8_t c, ...)
{
	va_list args;
	u2f_prints(tag);
    va_start(args,c);
    while(c--)
    {
        u2f_putd((int32_t)va_arg(args, int16_t));

    }
    put_line();
    va_end(args);
}

void u2f_printl(const char * tag, uint8_t c, ...)
{
    va_list args;
    u2f_prints(tag);
    va_start(args,c);
    while(c--)
    {
        u2f_putl(va_arg(args, int32_t));
        u2f_prints(" ");
    }
    put_line();
    va_end(args);
}

void u2f_printx(const char * tag, uint8_t c, ...)
{
    va_list args;
    u2f_prints(tag);
    va_start(args,c);
    while(c--)
    {
        u2f_putx((int32_t)va_arg(args, uint16_t));
        u2f_prints(" ");
    }
    put_line();
    va_end(args);
}

void u2f_printb(const char * tag, uint8_t c, ...)
{
	va_list args;
    u2f_prints(tag);
    va_start(args,c);
    while(c--)
    {
        u2f_putb(va_arg(args, uint8_t));
        put_space();
    }
    put_line();
    va_end(args);
}

void u2f_printlx(const char * tag, uint8_t c, ...)
{
    va_list args;
    u2f_prints(tag);
    va_start(args,c);
    while(c--)
    {
        u2f_putlx(va_arg(args, int32_t));
        put_space();
    }
    put_line();
    va_end(args);
}

#else




#endif
