conorpp/u2f-zero/firmware/src/cert.c

// generated
#include <stdint.h>

code uint8_t __attest[] = 
"\x30\x82\x01\x7a\x30\x82\x01\x20\x02\x09\x00\x91\x50\x9a\xea\x28\x11\xef\x7c\x30"
"\x0a\x06\x08\x2a\x86\x48\xce\x3d\x04\x03\x02\x30\x45\x31\x0b\x30\x09\x06\x03\x55"
"\x04\x06\x13\x02\x41\x55\x31\x13\x30\x11\x06\x03\x55\x04\x08\x0c\x0a\x53\x6f\x6d"
"\x65\x2d\x53\x74\x61\x74\x65\x31\x21\x30\x1f\x06\x03\x55\x04\x0a\x0c\x18\x49\x6e"
"\x74\x65\x72\x6e\x65\x74\x20\x57\x69\x64\x67\x69\x74\x73\x20\x50\x74\x79\x20\x4c"
"\x74\x64\x30\x1e\x17\x0d\x31\x37\x30\x31\x32\x38\x30\x36\x31\x37\x34\x39\x5a\x17"
"\x0d\x31\x37\x30\x32\x32\x37\x30\x36\x31\x37\x34\x39\x5a\x30\x45\x31\x0b\x30\x09"
"\x06\x03\x55\x04\x06\x13\x02\x41\x55\x31\x13\x30\x11\x06\x03\x55\x04\x08\x0c\x0a"
"\x53\x6f\x6d\x65\x2d\x53\x74\x61\x74\x65\x31\x21\x30\x1f\x06\x03\x55\x04\x0a\x0c"
"\x18\x49\x6e\x74\x65\x72\x6e\x65\x74\x20\x57\x69\x64\x67\x69\x74\x73\x20\x50\x74"
"\x79\x20\x4c\x74\x64\x30\x59\x30\x13\x06\x07\x2a\x86\x48\xce\x3d\x02\x01\x06\x08"
"\x2a\x86\x48\xce\x3d\x03\x01\x07\x03\x42\x00\x04\x87\x8f\x54\x28\x5a\xd5\x19\xb4"
"\xc0\x95\x13\xad\x22\x66\xec\x6a\x81\x52\xe6\x11\xa9\x33\xbb\x3d\xdc\xde\x92\xc2"
"\x40\x53\x9d\x39\x91\xea\xf2\x0a\x96\x61\x30\x2f\xec\x65\x4c\x80\xaa\xba\x15\xeb"
"\x9a\x70\x4c\x80\x59\x93\x7a\x51\xbe\x07\xc3\x26\x85\xab\xb0\x2b\x30\x0a\x06\x08"
"\x2a\x86\x48\xce\x3d\x04\x03\x02\x03\x48\x00\x30\x45\x02\x21\x00\xed\x71\xd4\x19"
"\x01\xa2\xfe\xa5\xa8\x6e\xa9\xa4\x8c\xf4\xcb\xc6\x7f\xc7\x92\x28\x56\xfa\x05\x01"
"\xa9\xc9\xbf\xfb\x2e\x83\x24\x33\x02\x20\x3c\x56\x15\x7c\x11\x8b\x46\xd2\x53\xf9"
"\xac\x96\xf6\xd0\xab\x4d\x0f\xf7\x4a\xf0\xb0\xaf\xfb\x8c\xd0\x18\xee\xf0\xc3\x73"
"\x68\x67"
;
const uint16_t __attest_size = sizeof(__attest)-1;

code uint8_t WMASK[] = "\x9b\x74\xbe\xd4\x00\xea\x52\x88\x6a\x9e\xb9\x5c\x69\x2a\x9c\x70\x0a\x4f\x20\xb5"
"\x66\x23\xa9\x57\xaf\x71\x59\xd8\xe8\xa6\x6e\x75\x2f\x29\x4e\x62";
code uint8_t RMASK[] = "\x48\x49\x97\x13\x47\xdb\xa0\x1d\x24\xfd\x5c\x32\x15\x66\xc6\x9d\x98\x22\x99\xe9"
"\xa0\x22\x28\x99\x79\x0b\xdd\x0f\x79\xa5\x2c\xe2";
