conorpp/u2f-zero/(commit log)

2015-12-31 schematic first draft
    [u2f-zero.kicad_pcb, u2f-zero.sch]
2015-12-31 allow kicad *.libs
2016-01-01 added button
    [u2f-zero.sch]
2016-01-01 100 ohms, crossouts
    [u2f-zero.sch]
2016-01-01 made footprints and assigned them
    [u2f-zero.sch]
2016-01-01 bug fixes, started layout
    [u2f-zero.sch]
2016-01-01 routing simplifications , rework schematic
    [u2f-zero.kicad_pcb, u2f-zero.sch]
2016-01-02 completed first draft of routing
    [u2f-zero.kicad_pcb]
2016-01-02 changed routing to fit 1.2x3.5
    [u2f-zero.kicad_pcb]
2016-01-02 fixed references
    [u2f-zero.kicad_pcb]
2016-01-02 replaced button, more fitting, usb outlines
    [u2f-zero.kicad_pcb, u2f-zero.sch]
2016-01-02 added usb open areas
    [u2f-zero.kicad_pcb]
2016-01-02 connected to usb pads
    [u2f-zero.kicad_pcb]
2016-01-02 some layout cleanup and made gerbers
    [u2f-zero.kicad_pcb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]
2016-01-02 final revision for first order
    [u2f-zero-B.Cu.gbr, u2f-zero-B.Mask.gbr, u2f-zero-B.SilkS.gbr, u2f-zero-Edge.Cuts.gbr, u2f-zero-F.Cu.gbr, u2f-zero-F.Mask.gbr, u2f-zero-F.SilkS.gbr, u2f-zero.drl]
2016-01-22 moved to folder
    [EFM8UB1_setup_board.GBL, EFM8UB1_setup_board.GBO, EFM8UB1_setup_board.GBS, EFM8UB1_setup_board.GKO, EFM8UB1_setup_board.GTL, EFM8UB1_setup_board.GTO, EFM8UB1_setup_board.GTS, EFM8UB1_setup_board.drl]
2016-01-22 added firmware
    [InitDevice.OBJ, SILABS_STARTUP.OBJ, callback.OBJ, descriptors.OBJ, idle.OBJ, u2f-firmware_main.OBJ]
2016-01-23 updated schematic/pcb for pca pins, debug header, and udfn8
    [u2f-zero.kicad_pcb, u2f-zero.sch]
2016-01-23 routed hot damn
    [u2f-zero.kicad_pcb, u2f-zero.sch]
2016-01-23 forgot a pin
    [u2f-zero.kicad_pcb]
2016-01-23 aligned and drew hole
    [u2f-zero.kicad_pcb]
2016-01-23 silk screen domain
    [u2f-zero.kicad_pcb]
2016-01-24 added gnd plane
    [u2f-zero.kicad_pcb]
2016-01-24 drc fixes
    [u2f-zero.kicad_pcb]
2016-01-24 slightly smaller
    [u2f-zero.GBL, u2f-zero.GBO, u2f-zero.GBS, u2f-zero.GKO, u2f-zero.GTL, u2f-zero.GTO, u2f-zero.GTS, u2f-zero.drl]
2016-01-24 its pretty shit messy but omg it works
    [InitDevice.OBJ, SILABS_STARTUP.OBJ, callback.OBJ, descriptors.OBJ, idle.OBJ, u2f-firmware_main.OBJ]
2016-01-24 .gitignore is now working
    [EFM8UB1_setup_board.GBL, EFM8UB1_setup_board.GBO, EFM8UB1_setup_board.GBS, EFM8UB1_setup_board.GKO, EFM8UB1_setup_board.GTL, EFM8UB1_setup_board.GTO, EFM8UB1_setup_board.GTS, EFM8UB1_setup_board.drl]
2016-01-26 added fifo and made main only do printf to prevent race conditions
    [u2f-zero.kicad_pcb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]
2016-02-01 added assigned pid from silicon labs
2016-02-14 i2c works but awfully messy and crc is incorrect
2016-02-14 i2c commands working
2016-02-14 refactored and rewrote i2c backend
2016-02-14 bug: forget to update length
    [atecc508a.c]
2016-02-14 working with 3 stage sha256 command
2016-02-22 wrote code for setting up device and locking it
2016-02-22 better error handling and bug fix
    [Interrupts.c, bsp.c, i2c.c, i2c.h]
2016-02-24 some bug fixes on cmd transport
    [Interrupts.c, app.h, atecc508a.c, atecc508a.h, i2c.c, i2c.h]
2016-02-29 replacement for *printf
2016-03-01 more lightweight printing and sequencing worked out
2016-03-04 cleaned up the printing situation
2016-03-06 fix mistake with rewriting config
    [app.h, u2f-atecc.c]
2016-03-06 im an idiot interrupt deadlock
2016-03-06 bug fixes and now registration msg works
    [app.h, atecc508a.c, bsp.c, main.c, u2f-atecc.c, u2f.c, u2f.h, u2f_hid.c]
2016-03-06 bug fix with setting length
    [u2f-atecc.c, u2f.c, u2f_hid.c]
2016-03-06 fix bug with written cert
    [u2f-atecc.c, u2f.c, u2f.h, u2f_hid.c, u2f_hid.h]
2016-03-06 not sure what is wrong but debugging failed signature
    [bsp.c, u2f-atecc.c, u2f.c]
2016-03-12 changed to verify der signatures
2016-03-12 made signatures der, bug fix, registration now works
    [app.h, bsp.c, main.c, u2f-atecc.c, u2f.c]
2016-03-15 pcb integration...
2016-03-17 pcb leds
2016-03-17 button pcb
2016-03-19 corrected pcb mistakes
    [u2f-zero.kicad_pcb, u2f-zero.sch]
2016-03-19 redid gnd plane and generated new gerbers
    [u2f-zero.kicad_pcb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]
2016-03-28 insert text/key tool
2016-03-29 some setup automation
    [InitDevice.OBJ, Interrupts.OBJ, SILABS_STARTUP.OBJ, atecc508a.OBJ, bsp.OBJ, callback.OBJ, descriptors.OBJ, eeprom.OBJ]
2016-03-29 it works!
    [InitDevice.OBJ, Interrupts.OBJ, SILABS_STARTUP.OBJ, atecc508a.OBJ, bsp.OBJ, callback.OBJ, descriptors.OBJ, eeprom.OBJ]
2016-03-29 gitignore resync
    [u2f-zero.kicad_pcb, u2f-zero.sch]
2016-03-30 clean up, footprint reduction, watch dog timer
2016-04-07 switched to qsop24 and soic8
    [u2f-zero.kicad_pcb, u2f-zero.sch]
2016-04-07 new board
    [u2f-zero.kicad_pcb]
2016-04-07 print number of seeded bytes
2016-04-24 tweaks to qsop footprint and move resistor closer in
    [u2f-zero.kicad_pcb, u2f-zero.sch]
2016-04-24 move caps in closer
    [u2f-zero.kicad_pcb]
2016-04-24 add datasheets
    [u2f-zero.sch]
2016-04-24 add part references
    [u2f-zero.sch]
2016-04-24 add fiducials
    [u2f-zero.kicad_pcb, u2f-zero.sch]
2016-04-24 generate bom
    [u2f-zero.csv]
2016-04-24 fix origin and remove unecessary bom elements
    [u2f-zero.csv, u2f-zero.kicad_pcb]
2016-04-24 fix some footprints
    [u2f-zero.kicad_pcb]
2016-05-25 move a trace
    [u2f-zero.kicad_pcb]
2016-05-28 added 3d printable case
    [u2f-zero-case .stl, u2f-zero-case v16.iges]
2016-06-05 add flashing harness
    [flashing_harness.FCStd, flashing_harness.stl]
2016-06-16 fixed printing error
2016-06-22 fixed crazy bug with first time programming crashing
    [bsp.c, main.c, u2f_atecc.c]
2016-07-01 add 3x1 panel and ICSP legend
    [u2f-zero-panel.kicad_pcb]
2016-08-14 replace recursion usage with iteration
    [app.h, main.c, u2f_hid.c]
2016-08-16 fix some edge cases exposed by fido test program
    [main.c, u2f_hid.c, u2f_hid.h]
2016-08-17 add error for running out of key space
    [u2f.c, u2f.h]
2016-08-22 add bottom silk screen to label bottom pins
    [u2f-zero.kicad_pcb]
2016-11-12 Revert "add bottom silk screen to label bottom pins"
    This reverts commit c896699ba735c471a4fbebd57787698f932a9618.
    [u2f-zero.kicad_pcb]
2016-11-13 undo revert
    [u2f-zero.kicad_pcb]
2016-11-13 Improve PCB layout for SI, EMC, ESD, fab yield
    [u2f-zero.kicad_pcb]
2017-01-25 reinforce key ring hole with copper plating
    [u2f-zero.kicad_pcb]
2017-02-10 error wipe hang fix
    [main.c]
2018-04-08 Replace tiny schematic/netlist parts with larger parts.
    All passive components: standardized on 0805
    TVS diode: currently TSOT-23-5 (could become 6 pins)
    LED: 0606 => 5050 (8.3x the horizontal linear size)
    [u2f-zero.sch]
2018-04-08 Update the PCB design with an eye towards keeping the LED centered
    [u2f-zero.kicad_pcb]
2018-04-08 Update for actual physical LED/TVS parts chosen
    [u2f-zero.kicad_pcb, u2f-zero.sch]
2018-04-08 Update panelization file with new U2F0H designs
    [u2f-zero-panel.kicad_pcb]
2018-04-08 Fix the positioning of the forward fiducial, in both the single/panel designs
    [u2f-zero-panel.kicad_pcb, u2f-zero.kicad_pcb]
2018-04-08 Move the mousebites out of the panelized board, reducing hole insets
    [u2f-zero-panel.kicad_pcb]
2018-04-08 Mass move the panelized design back into the design page
    [u2f-zero-panel.kicad_pcb]
2018-04-08 Move the C4 label out from under the fiducial.
    Discovered the label was being destroyed since it was in the fiducial
    keep-out zone. Needed to move the GND trace in order to make room next
    to the cap.
    Unfortunately, we don't have a panelization script so I simply tweaked
    the panel by hand, which isn't ideal. Post-DRC fills look fine.
    [u2f-zero-panel.kicad_pcb, u2f-zero.kicad_pcb]
2018-04-08 Change the silkscreen labels back to 'U2F Zero' from WIP 'U2F0H' label
    [u2f-zero-panel.kicad_pcb, u2f-zero.kicad_pcb]
2018-04-08 Update the BOM csv with new values matching the larger footprints
    [u2f-zero.csv, u2f-zero.sch]
2018-04-27 Fix BOM xsl to exclude debug pins and the like
2018-04-27 Fix BOM xsl to quote strings containing commas
2018-04-27 Fix BOM xsl, removed leading spaces from fields
2018-04-27 Add newly generated BOM CSV
    [u2f-zero.csv]
2022-01-18 Update u2f-zero.csv
    Fix bad link to ATECC508A datasheet.
    [u2f-zero.csv]
